rhinosys/turingpi2_rack/docs/index.md

# Turing Pi 2 · Rack Blade

**19-inch / 4U · Two removable nodes · SolidCraft CAD · Black PETG**

[English documentation](en/index.md) · [Documentation française](fr/index.md)

Integrated enclosure, V6 architecture retained in V7

A documented prototype, from the initial brief to calibrated printing files and physical fit corrections.
Un prototype documenté, du cahier des charges initial aux fichiers d’impression calibrés et aux corrections après essai.

**Current / Actuel:** rack **V7 calibrated / calibrée**, rail saddles / supports de rails **R3**.

[GitHub sources](https://github.com/rhinosys/turingpi2_rack) · [Downloads / Téléchargements](en/files.md)
