rhinosys/turingpi2_rack/CAD/RackBladeSolidCraft/LIRE_V5.md

# Ouvrir la version 5

Fichier complet : **[RackTuringPi2_Complet_V5.solidcraft](RackTuringPi2_Complet_V5.solidcraft)**.

Cette version remplace le tiroir court par deux cassettes complètes. Façade, plateau, carte, ventilateur, alimentation et paroi arrière sont regroupés dans **CASSETTE-G** et **CASSETTE-D**. Les câbles externes doivent être débranchés avant extraction. Le châssis fixe conserve structure, guides et enveloppe de ventilation.

Voir **[la notice V5](V5/README.md)** pour les vues, pièces imprimables, étapes de montage et limites du prototype. Les anciennes notices V1/V2 et l'animation du tiroir court expliquent le R3/R4 ; elles ne décrivent pas le nouveau fond mobile de V5.

Extraction complète V5

Rechargement natif vérifié : 53 corps, 743 opérations, aucune erreur. Chaque corps comporte une coque. Les essais discrets de mouvement sont consignés dans `V5/verification/`.
