rhinosys/turingpi2_rack/CAD/RackBladeSolidCraft/animation-guidage/sortie.png

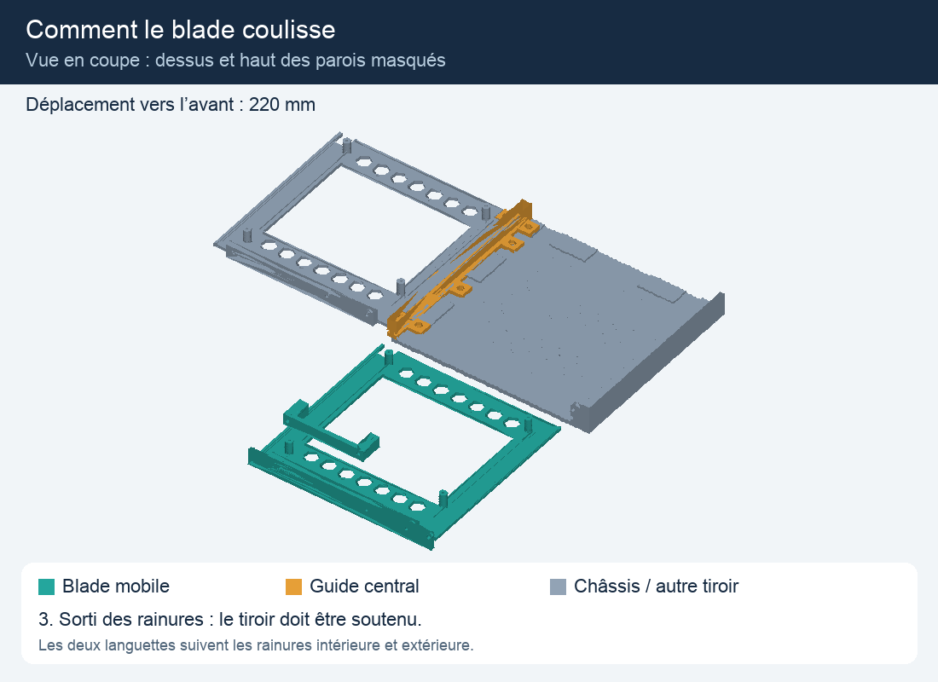
CAD/RackBladeSolidCraft/animation-guidage/sortie.png
