rhinosys/turingpi2_rack/CAD/RackBladeSolidCraft/notice-visuelle/blade.png

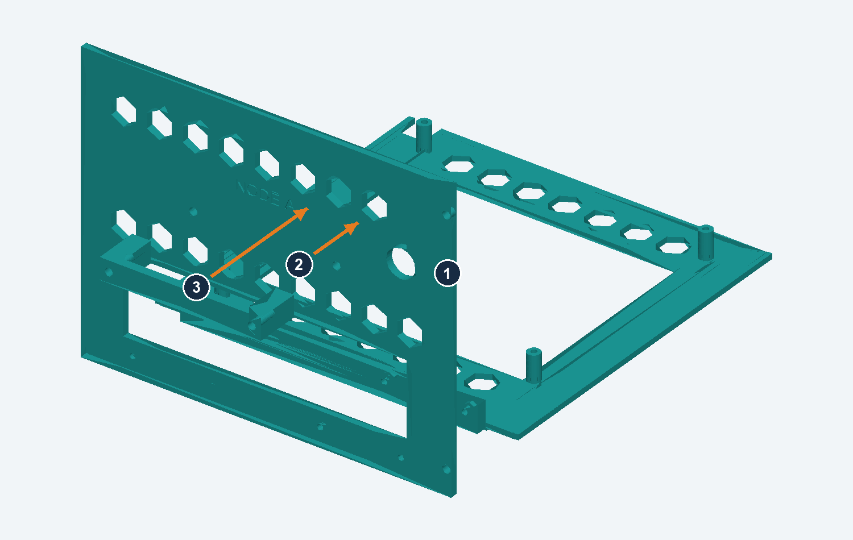
CAD/RackBladeSolidCraft/notice-visuelle/blade.png
