rhinosys/turingpi2_rack/CAD/RackBladeSolidCraft/notice-visuelle/capots.png

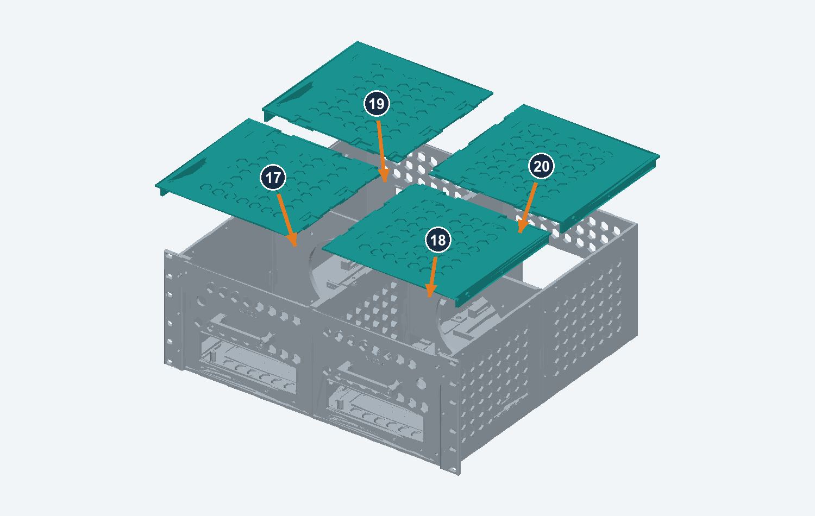
CAD/RackBladeSolidCraft/notice-visuelle/capots.png
