rhinosys/turingpi2_rack/CAD/RackBladeSolidCraft/notice-visuelle/cloisons.png

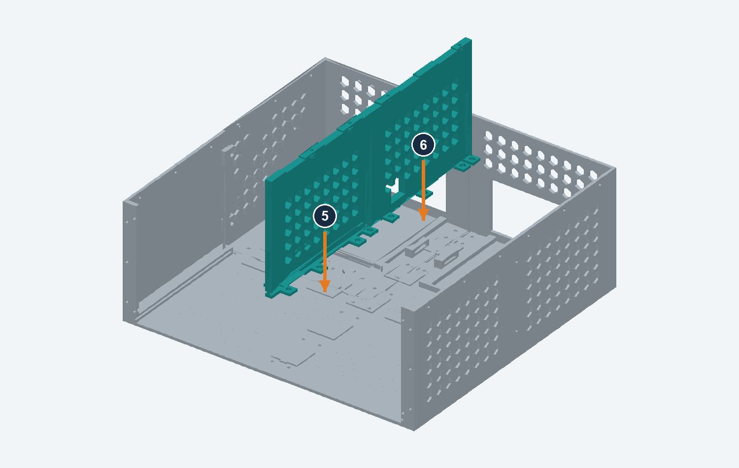
CAD/RackBladeSolidCraft/notice-visuelle/cloisons.png
