rhinosys/turingpi2_rack/CAD/RackBladeSolidCraft/notice-visuelle/final.png

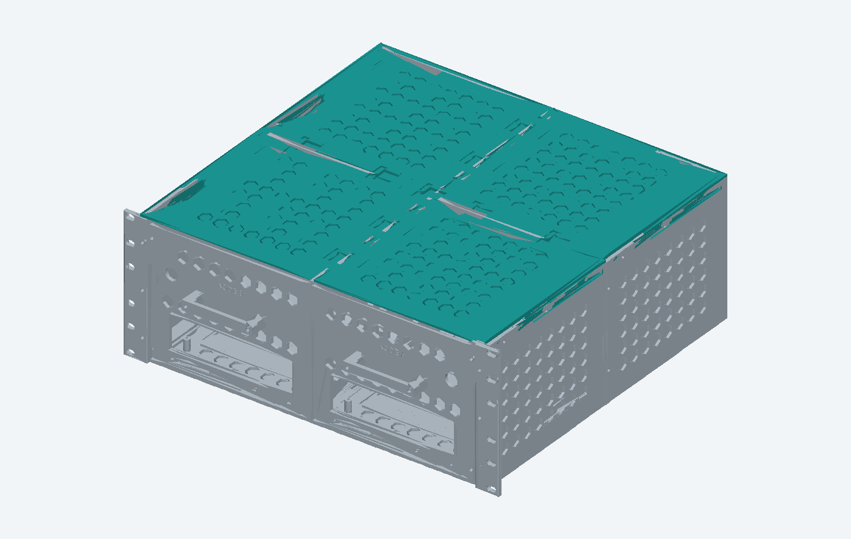
CAD/RackBladeSolidCraft/notice-visuelle/final.png
