rhinosys/turingpi2_rack/CAD/RackBladeSolidCraft/notice-visuelle/guidage.png

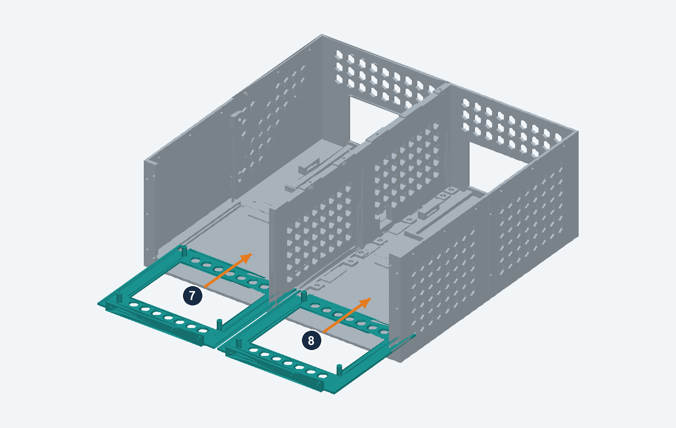
CAD/RackBladeSolidCraft/notice-visuelle/guidage.png
