rhinosys/turingpi2_rack/CAD/RackBladeSolidCraft/notice-visuelle/oreilles.png

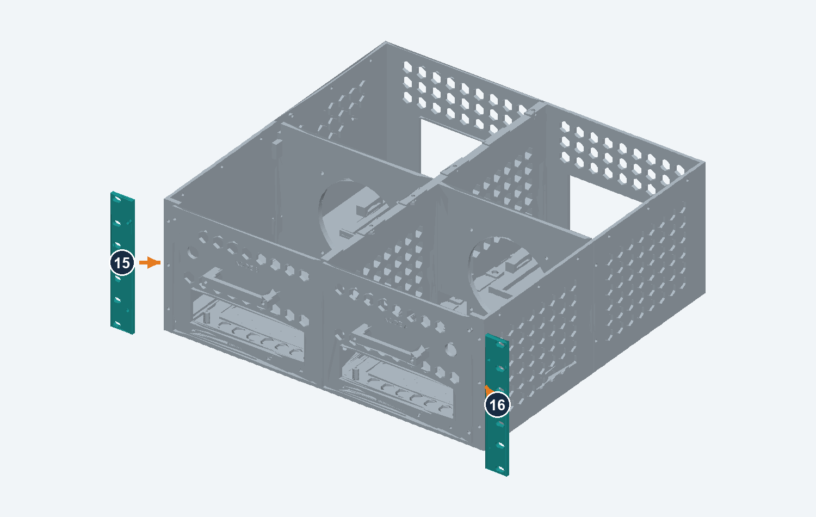
CAD/RackBladeSolidCraft/notice-visuelle/oreilles.png
