rhinosys/turingpi2_rack/CAD/RackBladeSolidCraft/notice-visuelle/quadrants.png

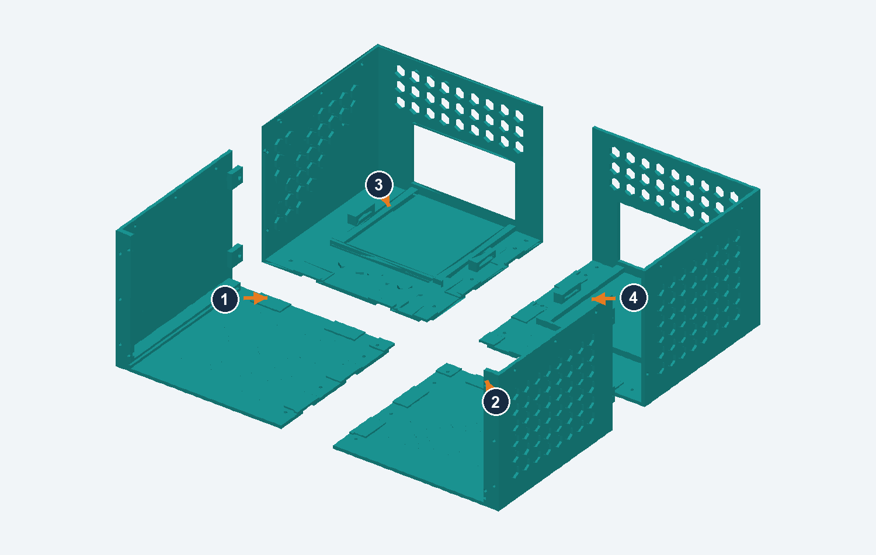
CAD/RackBladeSolidCraft/notice-visuelle/quadrants.png
