rhinosys/turingpi2_rack/CAD/RackBladeSolidCraft/notice-visuelle/ventilos.png

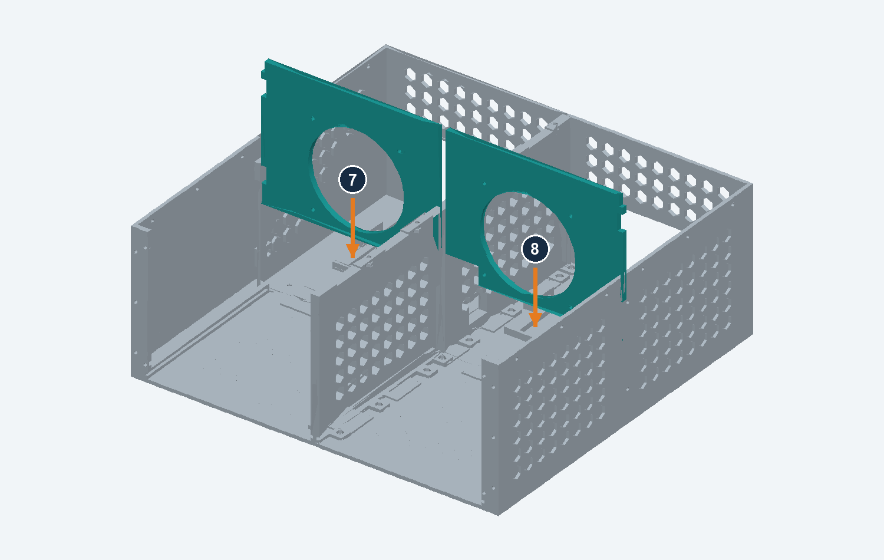
CAD/RackBladeSolidCraft/notice-visuelle/ventilos.png
