rhinosys/turingpi2_rack/CAD/RackBladeSolidCraft/previews/part-BIS-X.png

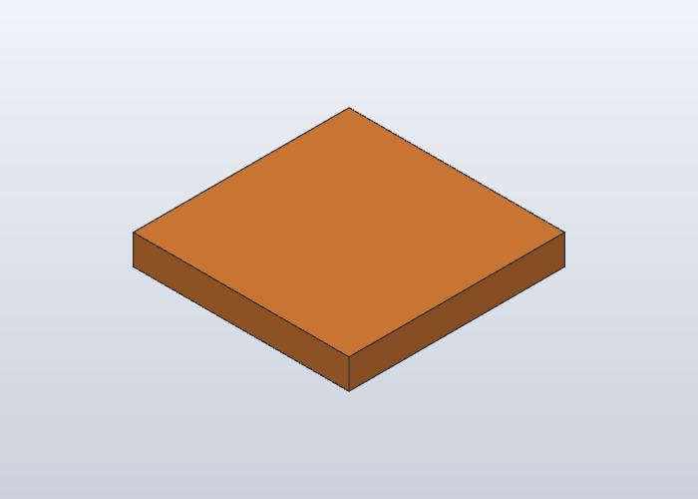
CAD/RackBladeSolidCraft/previews/part-BIS-X.png
