rhinosys/turingpi2_rack/CAD/RackBladeSolidCraft/previews/part-BT-D.png

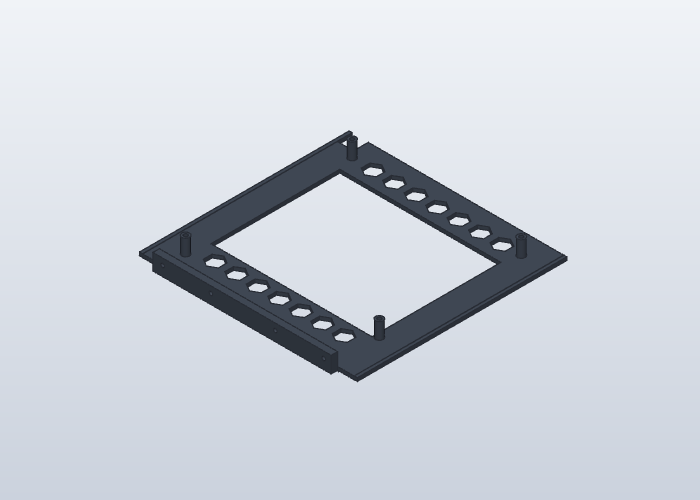
CAD/RackBladeSolidCraft/previews/part-BT-D.png
