rhinosys/turingpi2_rack/CAD/RackBladeSolidCraft/previews/part-EAR-D.png

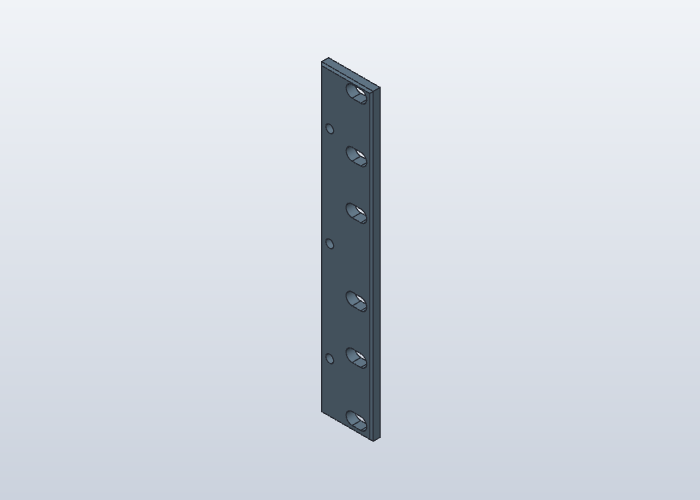
CAD/RackBladeSolidCraft/previews/part-EAR-D.png
