rhinosys/turingpi2_rack/CAD/RackBladeSolidCraft/previews/part-FW-D.png

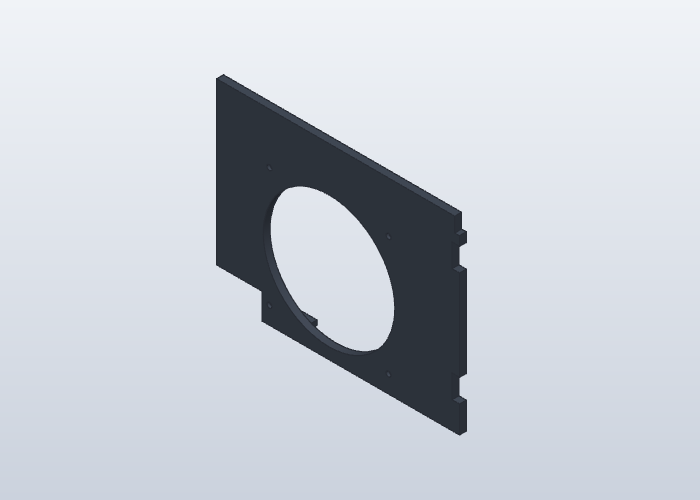
CAD/RackBladeSolidCraft/previews/part-FW-D.png
