rhinosys/turingpi2_rack/CAD/RackBladeSolidCraft/previews/part-HANDLE-D.png

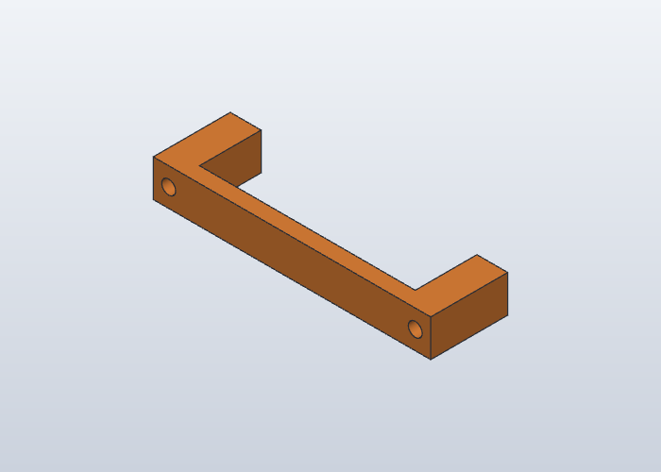
CAD/RackBladeSolidCraft/previews/part-HANDLE-D.png
