rhinosys/turingpi2_rack/CAD/RackBladeSolidCraft/previews/part-Q-AR-D.png

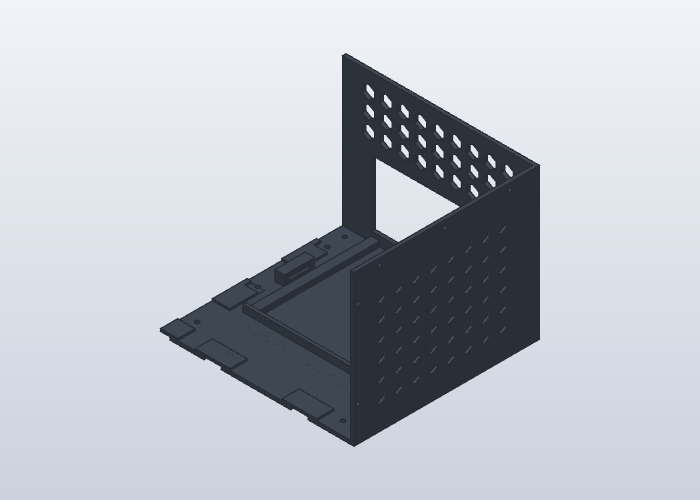
CAD/RackBladeSolidCraft/previews/part-Q-AR-D.png
