rhinosys/turingpi2_rack/CAD/RackBladeSolidCraft/previews/part-Q-AR-G.png

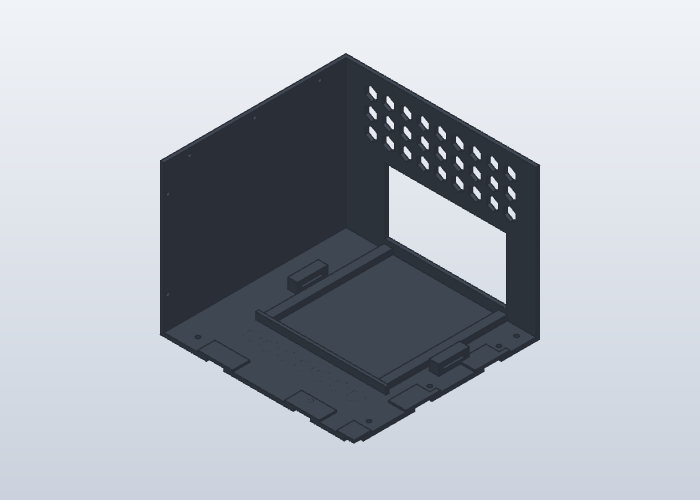
CAD/RackBladeSolidCraft/previews/part-Q-AR-G.png
