rhinosys/turingpi2_rack/CAD/RackBladeSolidCraft/previews/part-Q-AV-D.png

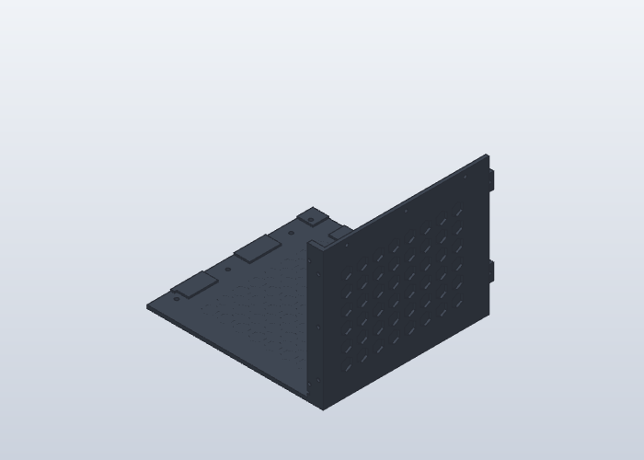
CAD/RackBladeSolidCraft/previews/part-Q-AV-D.png
