rhinosys/turingpi2_rack/CAD/RackBladeSolidCraft/previews/part-TOP-AR-D.png

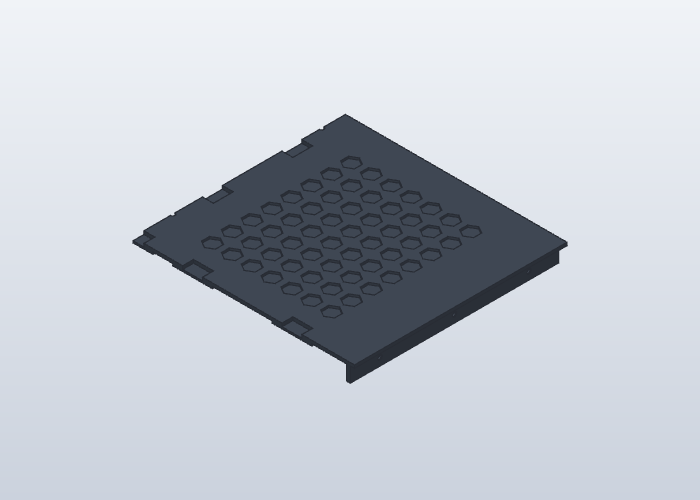
CAD/RackBladeSolidCraft/previews/part-TOP-AR-D.png
