rhinosys/turingpi2_rack/CAD/RackBladeSolidCraft/V7/plateaux/01_Q-AV-D.png

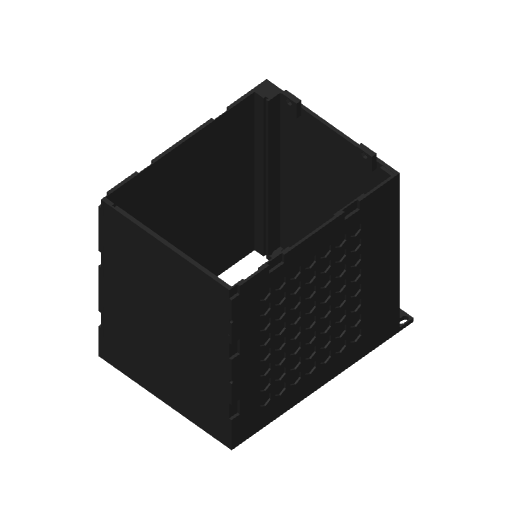
CAD/RackBladeSolidCraft/V7/plateaux/01_Q-AV-D.png
