rhinosys/turingpi2_rack/CAD/RackBladeSolidCraft/V7/plateaux/03_Q-AR-D.png

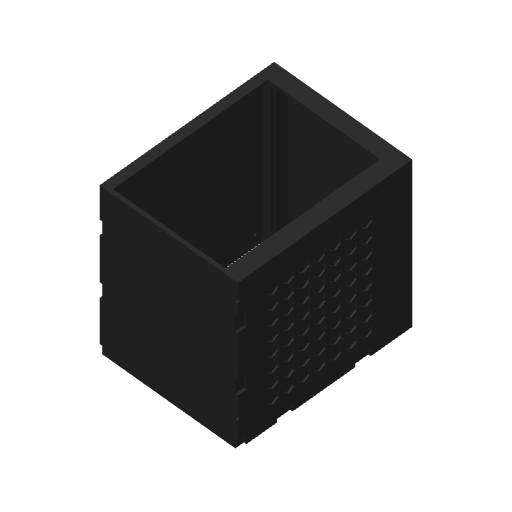
CAD/RackBladeSolidCraft/V7/plateaux/03_Q-AR-D.png
