rhinosys/turingpi2_rack/CAD/RackBladeSolidCraft/V7/plateaux/05_BT-D.png

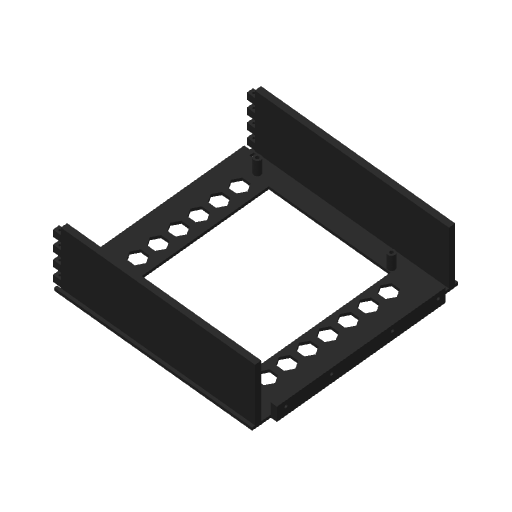
CAD/RackBladeSolidCraft/V7/plateaux/05_BT-D.png
