rhinosys/turingpi2_rack/CAD/RackBladeSolidCraft/V7/plateaux/06_FOND-AR-D.png

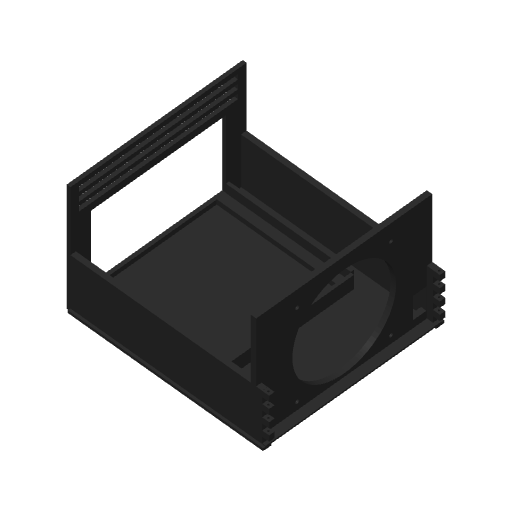
CAD/RackBladeSolidCraft/V7/plateaux/06_FOND-AR-D.png
