rhinosys/turingpi2_rack/CAD/RackBladeSolidCraft/V7/plateaux/09_Facade_D_poignee_biscuits.png

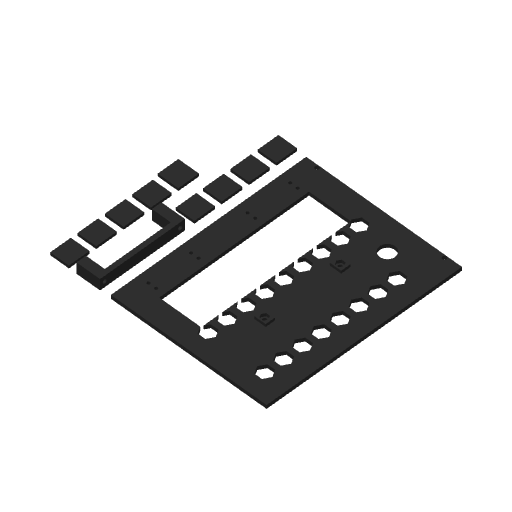
CAD/RackBladeSolidCraft/V7/plateaux/09_Facade_D_poignee_biscuits.png
