rhinosys/turingpi2_rack/CAD/RackBladeSolidCraft/V7/exports/Assemblage_V7.step

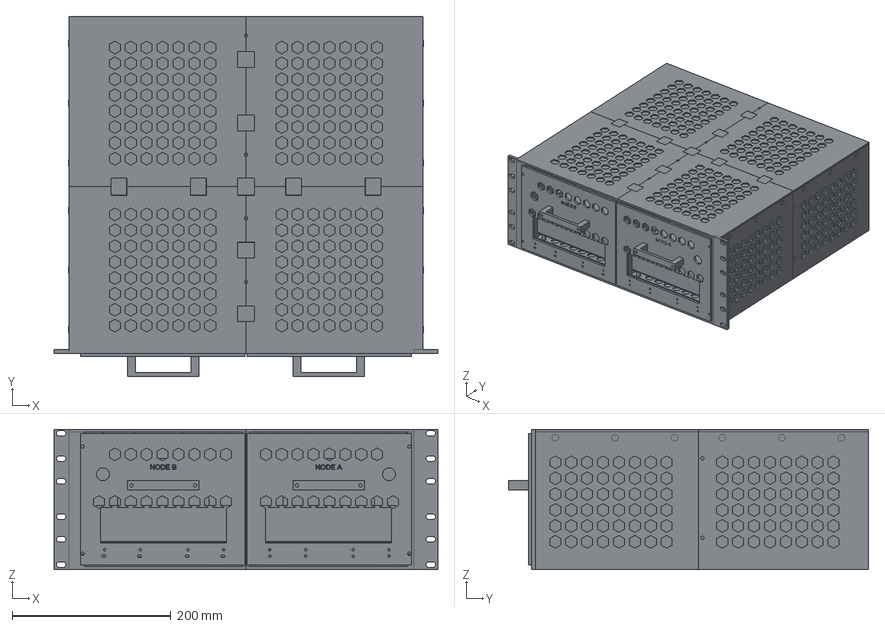
[picture p45: CAD file, 2026-10-26]
CAD/RackBladeSolidCraft/V7/exports/Assemblage_V7.step
482.6 x 453.0 x 176.5 mm
