rhinosys/turingpi2_rack/CAD/RackBladeSolidCraft/exports/3mf/BIS_20_plus_BIS-X_2.3mf

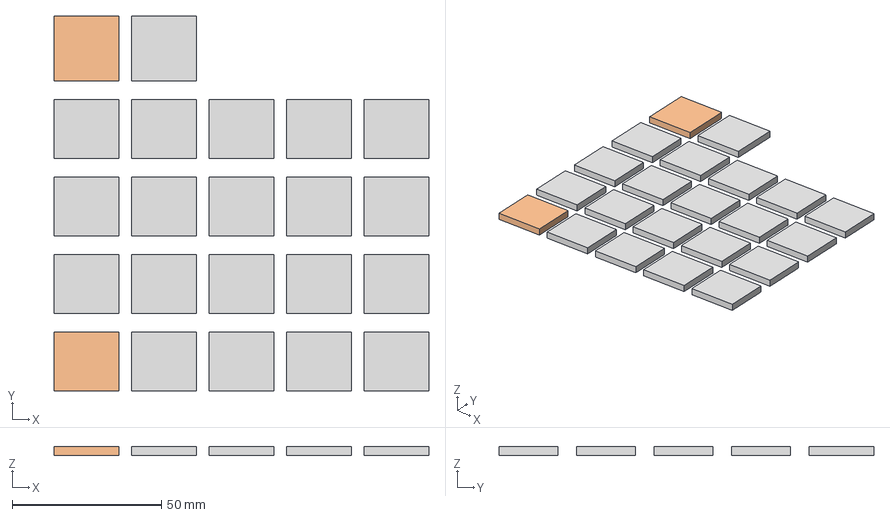
[picture p46: CAD file, 2026-10-26]
CAD/RackBladeSolidCraft/exports/3mf/BIS_20_plus_BIS-X_2.3mf
125.8 x 125.8 x 3.00 mm
BIS
BIS (2)
BIS (3)
BIS (4)
BIS (5)
BIS (6)
BIS (7)
BIS (8)
BIS (9)
BIS (10)
BIS (11)
BIS (12)
BIS (13)
BIS (14)
BIS (15)
BIS (16)
BIS (17)
BIS (18)
BIS (19)
BIS (20)
BIS-X (2)
BIS-X
