rhinosys/turingpi2_rack/CAD/RackBladeSolidCraft/exports/step/Q-AR-G.step

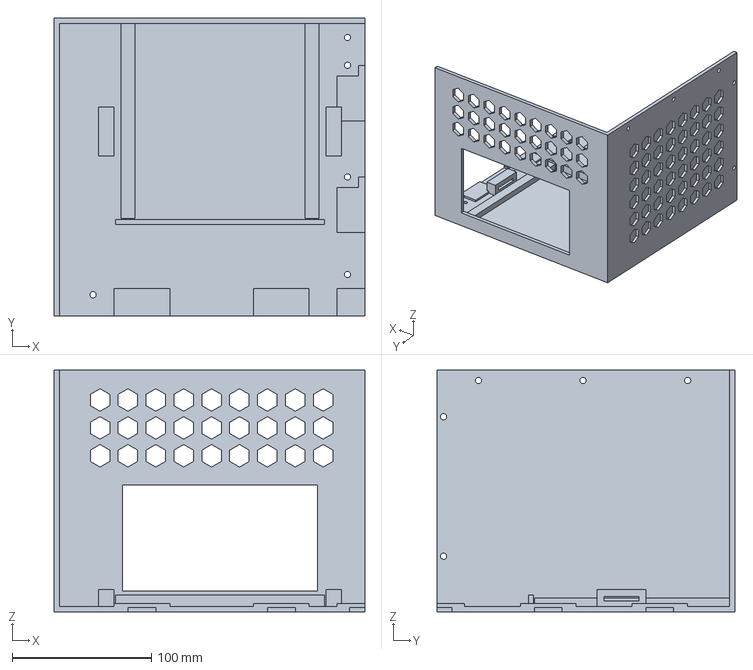
[picture p47: CAD file, 2026-10-26]
CAD/RackBladeSolidCraft/exports/step/Q-AR-G.step
223.0 x 213.8 x 173.5 mm
