rhinosys/turingpi2_rack/CAD/RackBladeSolidCraft/Supports_Rails_L/exports/BERCEAU-A.step

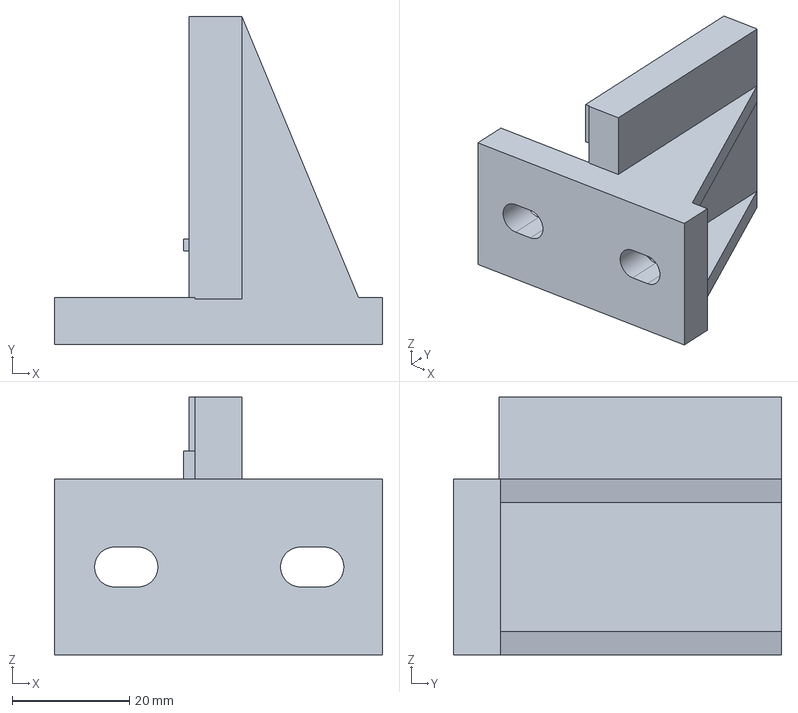
[picture p48: CAD file, 2026-10-26]
CAD/RackBladeSolidCraft/Supports_Rails_L/exports/BERCEAU-A.step
56.0 x 56.0 x 44.0 mm
