rhinosys/turingpi2_rack/CAD/RackBladeSolidCraft/Supports_Rails_L/Plateau_4_berceaux_PETG_noir.3mf

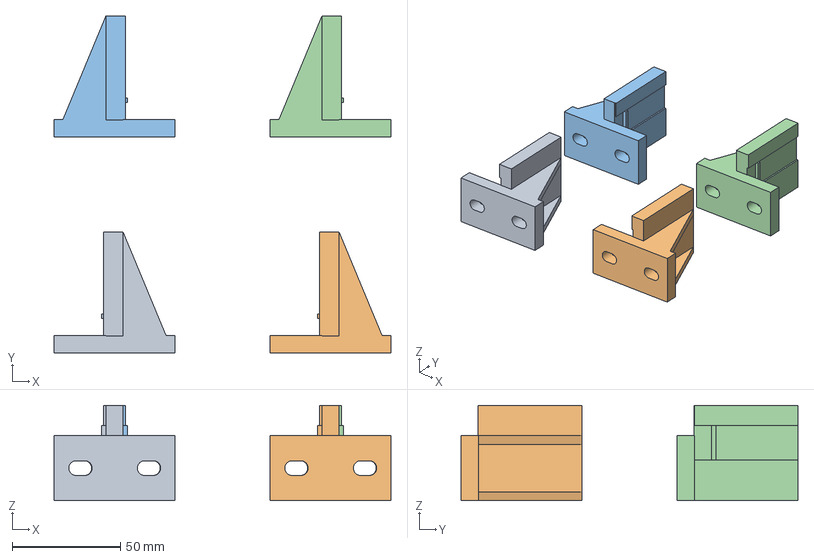
[picture p49: CAD file, 2026-10-26]
CAD/RackBladeSolidCraft/Supports_Rails_L/Plateau_4_berceaux_PETG_noir.3mf
156.0 x 156.0 x 44.0 mm
BERCEAU-A-1
BERCEAU-A-2
BERCEAU-B-3
BERCEAU-B-4
