rhinosys/turingpi2_rack/CAD/RackBladeSolidCraft/Supports_Rails_L/R2/Plateau_2_arriere_M4_R2_PETG_noir.3mf

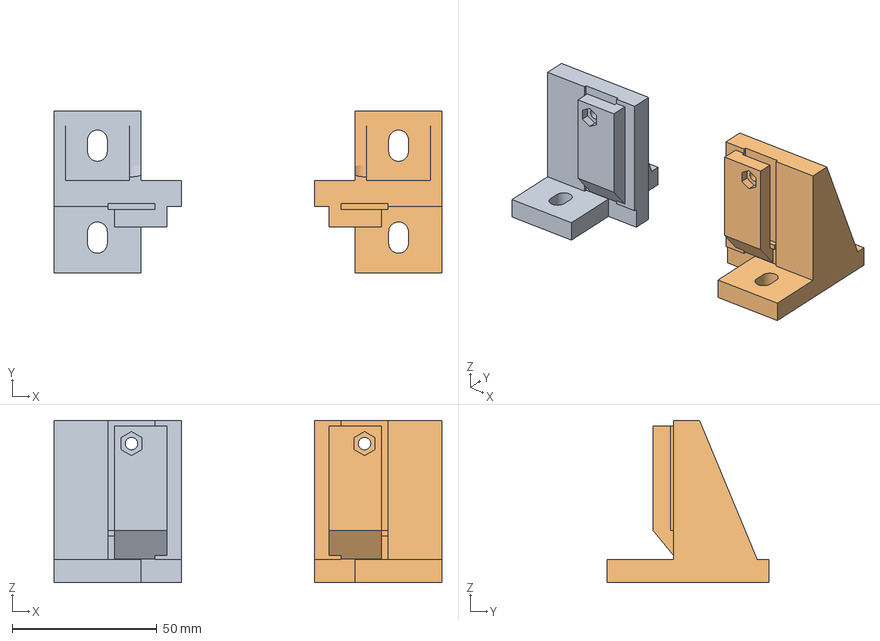
[picture p51: CAD file, 2026-10-26]
CAD/RackBladeSolidCraft/Supports_Rails_L/R2/Plateau_2_arriere_M4_R2_PETG_noir.3mf
134.0 x 56.0 x 56.0 mm
AR-A-1
AR-B-2
