rhinosys/turingpi2_rack/CAD/RackBladeSolidCraft/Supports_Rails_L/R3/exports/AR-A.step

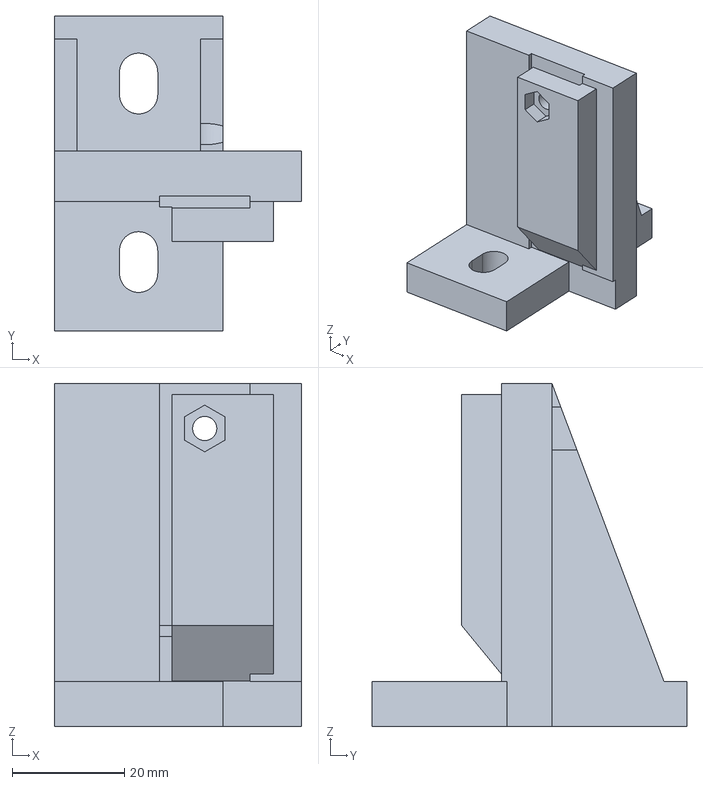
[picture p52: CAD file, 2026-10-26]
CAD/RackBladeSolidCraft/Supports_Rails_L/R3/exports/AR-A.step
44.0 x 56.0 x 61.0 mm
