rhinosys/turingpi2_rack/CAD/RackBladeSolidCraft/Supports_Rails_L/R3/Plateau_2_arriere_M4_R3_PETG_noir.3mf

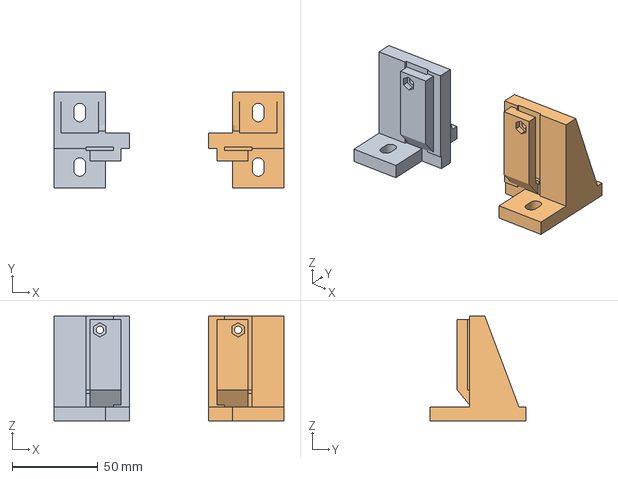
[picture p53: CAD file, 2026-10-26]
CAD/RackBladeSolidCraft/Supports_Rails_L/R3/Plateau_2_arriere_M4_R3_PETG_noir.3mf
134.0 x 56.0 x 61.0 mm
AR-A-1
AR-B-2
