rhinosys/turingpi2_rack/CAD/RackBladeSolidCraft/Tolerances/Rack_Tolerance_PETG_R1.step

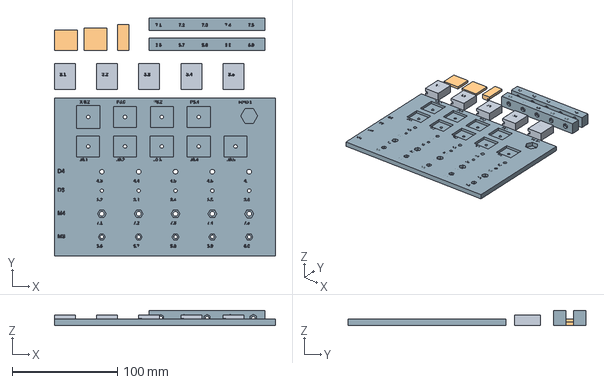
[picture p54: CAD file, 2026-10-26]
CAD/RackBladeSolidCraft/Tolerances/Rack_Tolerance_PETG_R1.step
210.0 x 226.0 x 14.0 mm
