rhinosys/turingpi2_rack/CAD/RackBladeSolidCraft/V7/exports/Q-AR-D_print.step

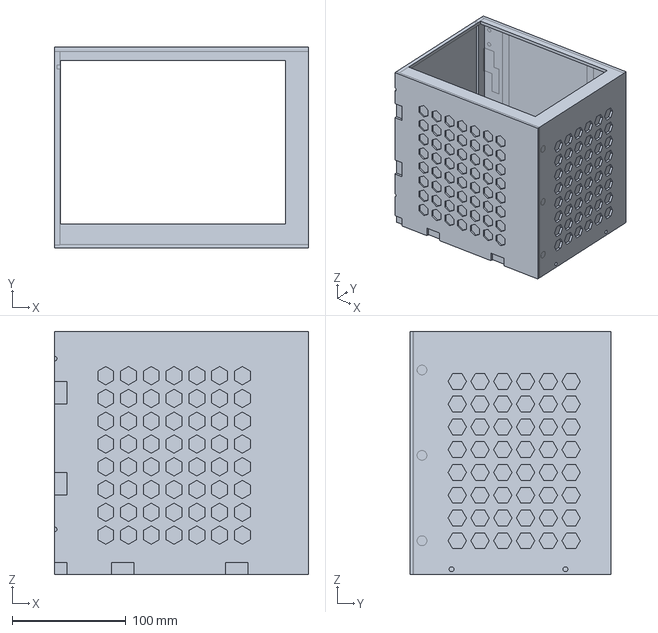
[picture p55: CAD file, 2026-10-26]
CAD/RackBladeSolidCraft/V7/exports/Q-AR-D_print.step
223.1 x 176.5 x 213.8 mm
