rhinosys/turingpi2_rack/CAD/RackBladeSolidCraft/V7/plateaux/01_Q-AV-D.3mf

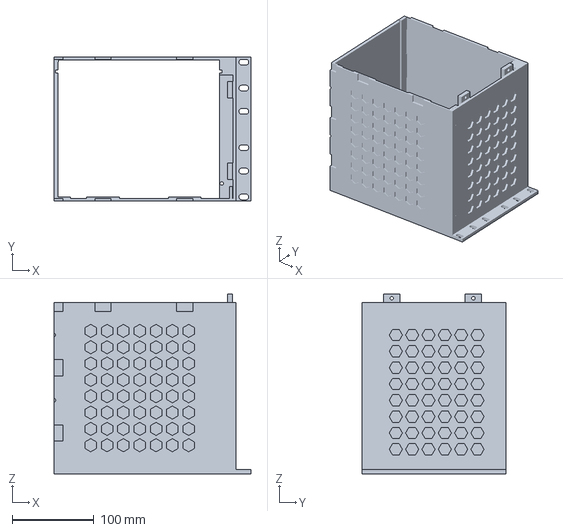
[picture p56: CAD file, 2026-10-26]
CAD/RackBladeSolidCraft/V7/plateaux/01_Q-AV-D.3mf
241.3 x 176.5 x 220.0 mm
