rhinosys/turingpi2_rack/CAD/RackBladeSolidCraft/Variants/Q-AV-G-EAR/Q-AV-G-EAR_face-avant.3mf

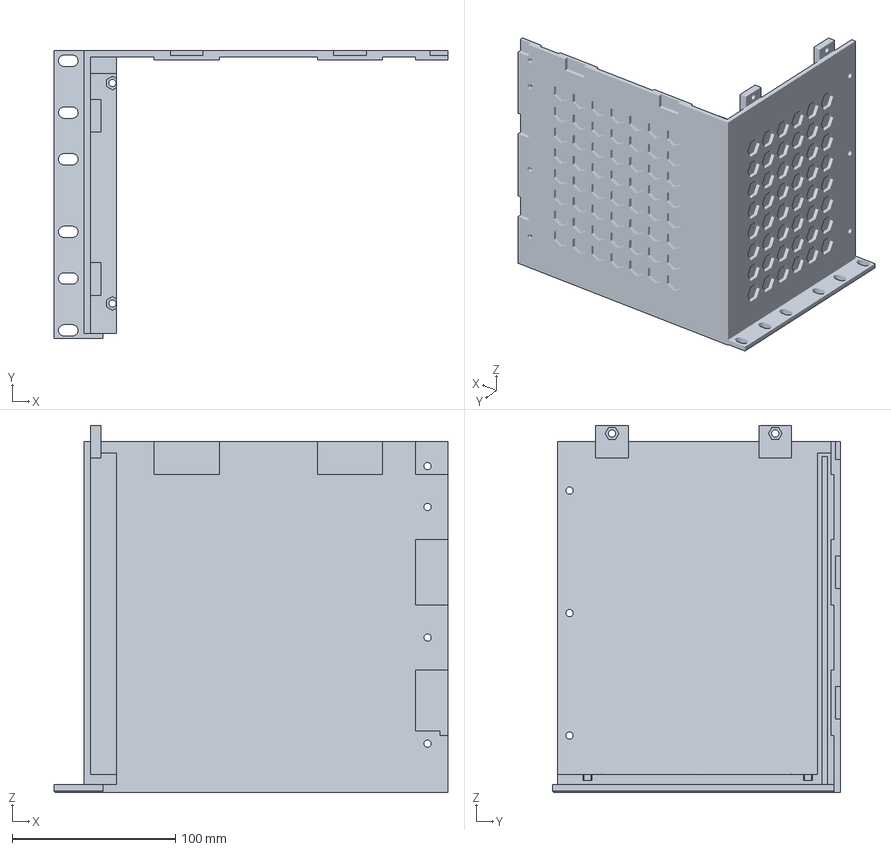
[picture p57: CAD file, 2026-10-26]
CAD/RackBladeSolidCraft/Variants/Q-AV-G-EAR/Q-AV-G-EAR_face-avant.3mf
241.3 x 176.5 x 225.0 mm
