rhinosys/turingpi2_rack/CAD/RackBladeSolidCraft/exports/step/BF-G.step

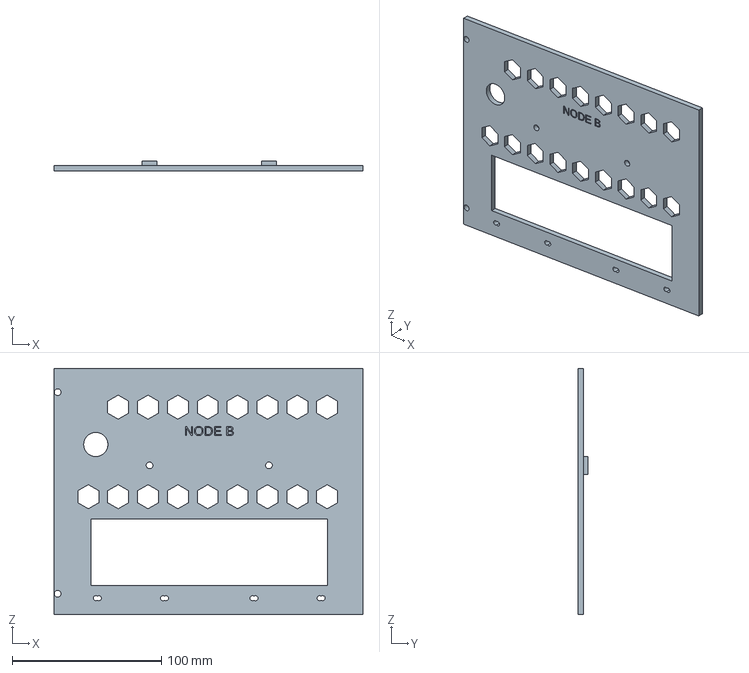
[picture p58: CAD file, 2026-10-26]
CAD/RackBladeSolidCraft/exports/step/BF-G.step
207.0 x 7.00 x 165.0 mm
