rhinosys/turingpi2_rack/CAD/RackBladeSolidCraft/Supports_Rails_L/exports/Montage_berceaux_reference.step

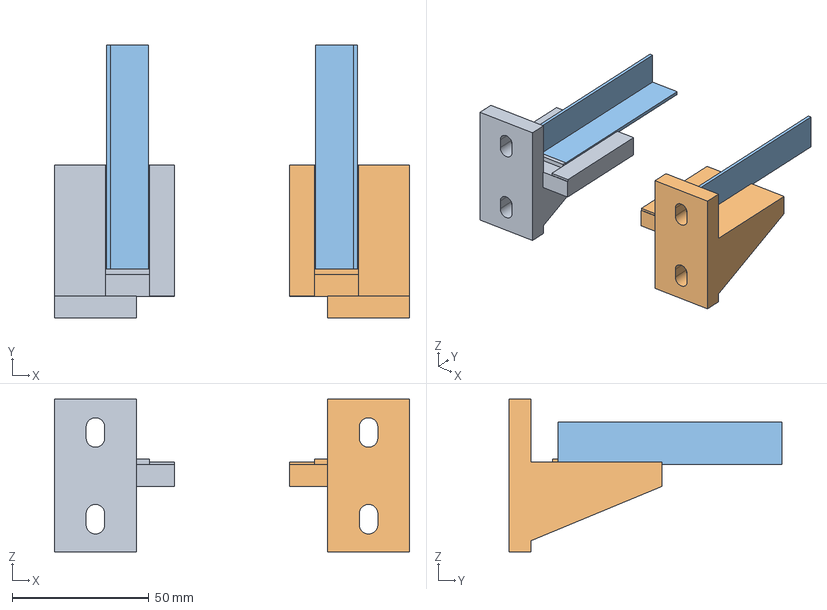
[picture p59: CAD file, 2026-10-26]
CAD/RackBladeSolidCraft/Supports_Rails_L/exports/Montage_berceaux_reference.step
130.0 x 100.0 x 56.0 mm
