rhinosys/turingpi2_rack/CAD/RackBladeSolidCraft/Supports_Rails_L/R2/exports/AR-A.step

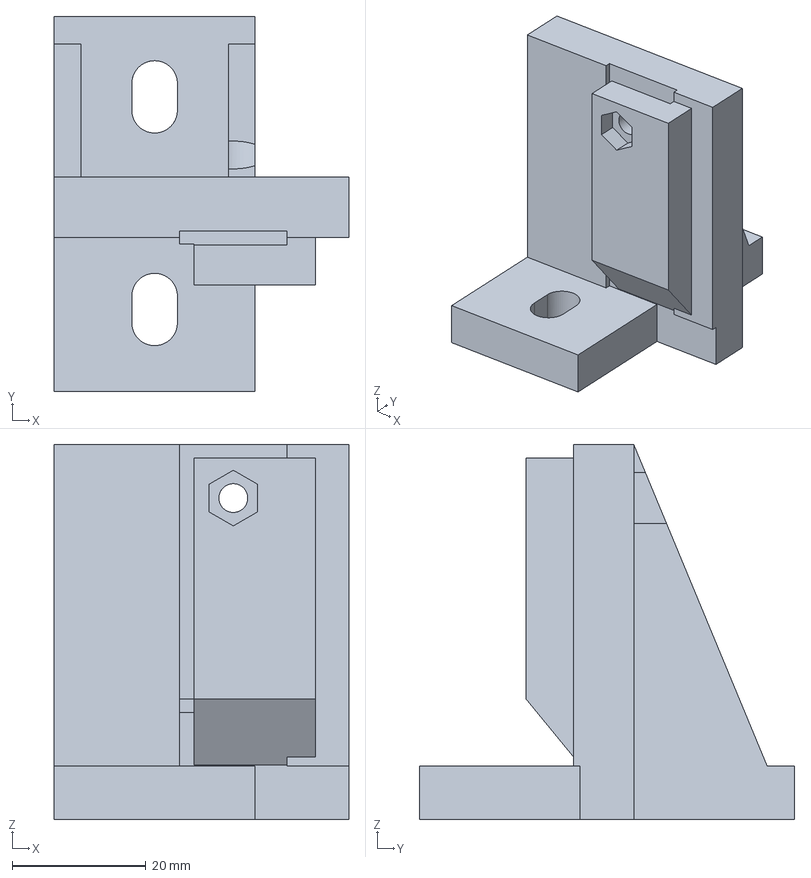
[picture p60: CAD file, 2026-10-26]
CAD/RackBladeSolidCraft/Supports_Rails_L/R2/exports/AR-A.step
44.0 x 56.0 x 56.0 mm
