rhinosys/turingpi2_rack/CAD/RackBladeSolidCraft/Supports_Rails_L/R2/Plateau_4_supports_R2_PETG_noir.3mf

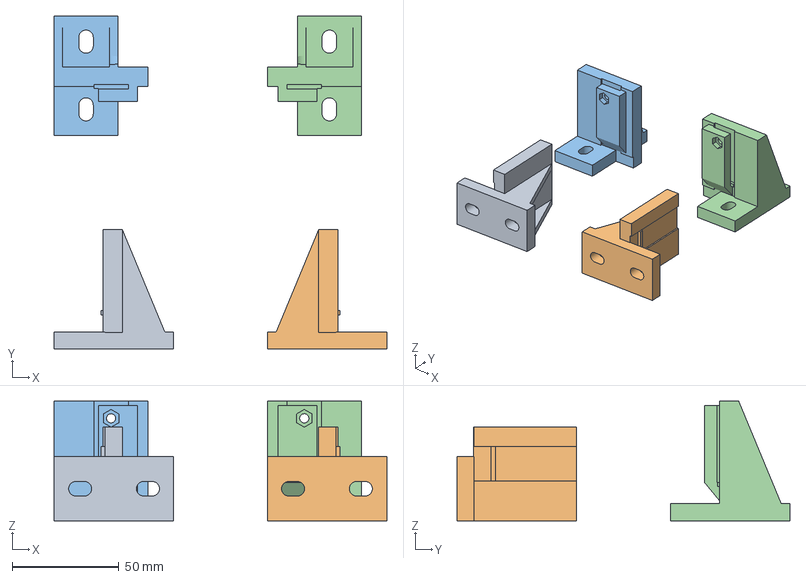
[picture p61: CAD file, 2026-10-26]
CAD/RackBladeSolidCraft/Supports_Rails_L/R2/Plateau_4_supports_R2_PETG_noir.3mf
156.0 x 156.0 x 56.0 mm
AV-A-1
AV-B-2
AR-A-3
AR-B-4
