rhinosys/turingpi2_rack/CAD/RackBladeSolidCraft/Supports_Rails_L/R3/Plateau_4_supports_R3_PETG_noir.3mf

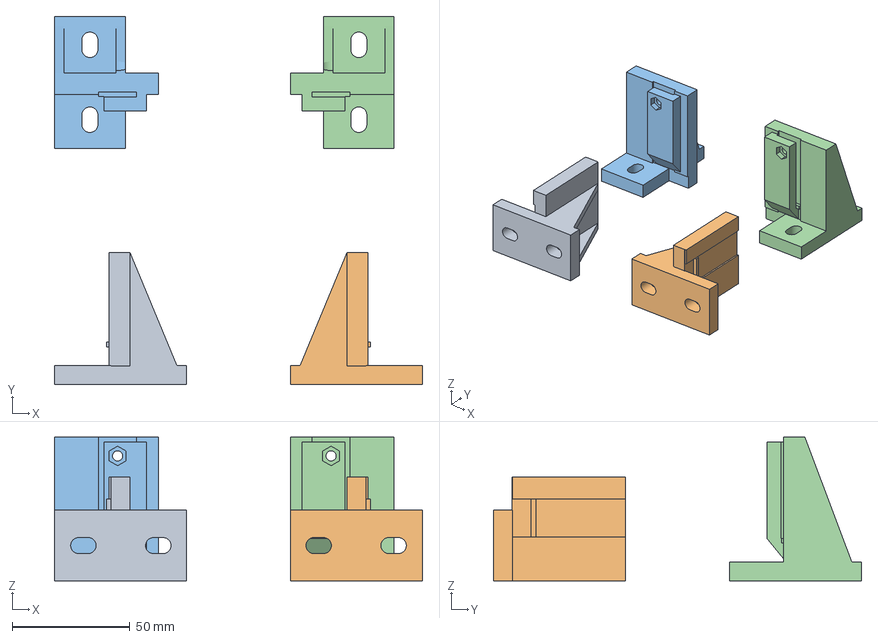
[picture p63: CAD file, 2026-10-26]
CAD/RackBladeSolidCraft/Supports_Rails_L/R3/Plateau_4_supports_R3_PETG_noir.3mf
156.0 x 156.0 x 61.0 mm
AV-A-1
AV-B-2
AR-A-3
AR-B-4
