rhinosys/turingpi2_rack/CAD/RackBladeSolidCraft/V7/exports/BT-D_print.step

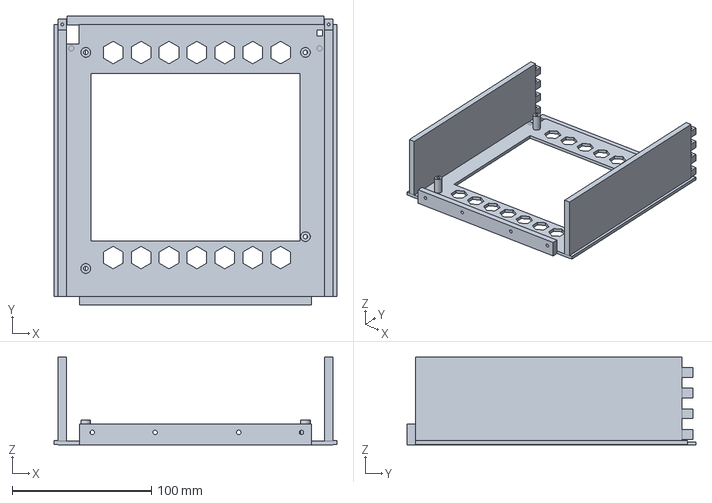
[picture p64: CAD file, 2026-10-26]
CAD/RackBladeSolidCraft/V7/exports/BT-D_print.step
202.8 x 207.2 x 63.0 mm
