rhinosys/turingpi2_rack/CAD/RackBladeSolidCraft/exports/step/HANDLE-G.step

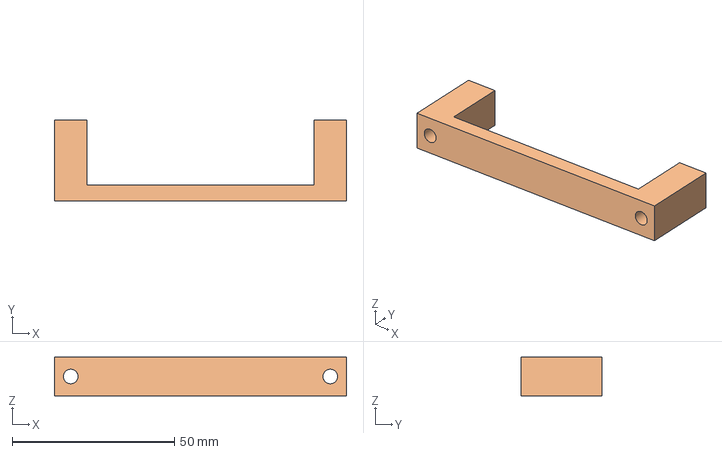
[picture p65: CAD file, 2026-10-26]
CAD/RackBladeSolidCraft/exports/step/HANDLE-G.step
90.0 x 25.0 x 12.0 mm
