rhinosys/turingpi2_rack/CAD/RackBladeSolidCraft/Supports_Rails_L/exports/Supports_Rails_L.step

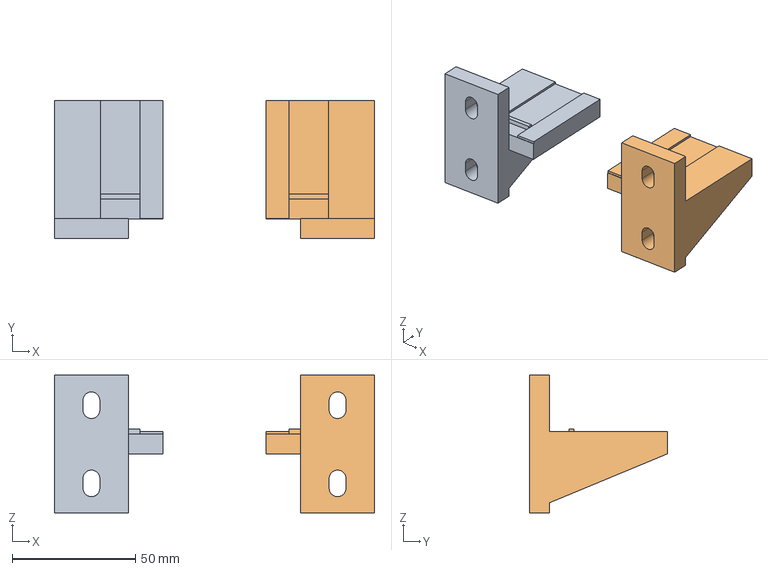
[picture p66: CAD file, 2026-10-26]
CAD/RackBladeSolidCraft/Supports_Rails_L/exports/Supports_Rails_L.step
130.0 x 56.0 x 56.0 mm
