rhinosys/turingpi2_rack/CAD/RackBladeSolidCraft/V7/plateaux/08_FOND-AR-G.3mf

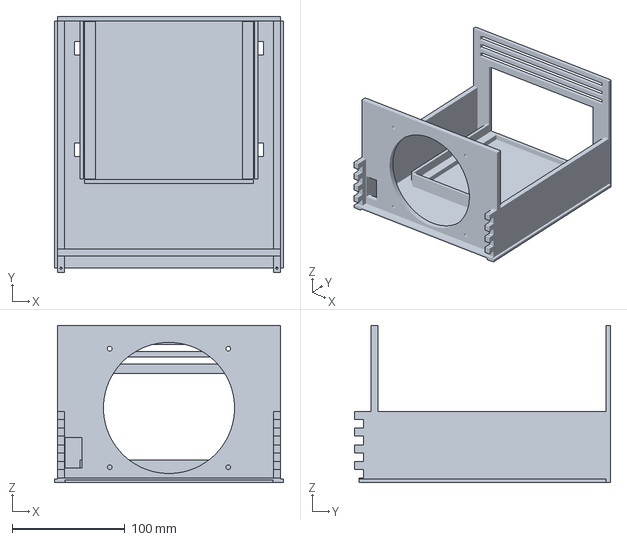
[picture p68: CAD file, 2026-10-26]
CAD/RackBladeSolidCraft/V7/plateaux/08_FOND-AR-G.3mf
202.8 x 226.6 x 139.0 mm
