rhinosys/turingpi2_rack/CAD/RackBladeSolidCraft/exports/step/EAR-D.step

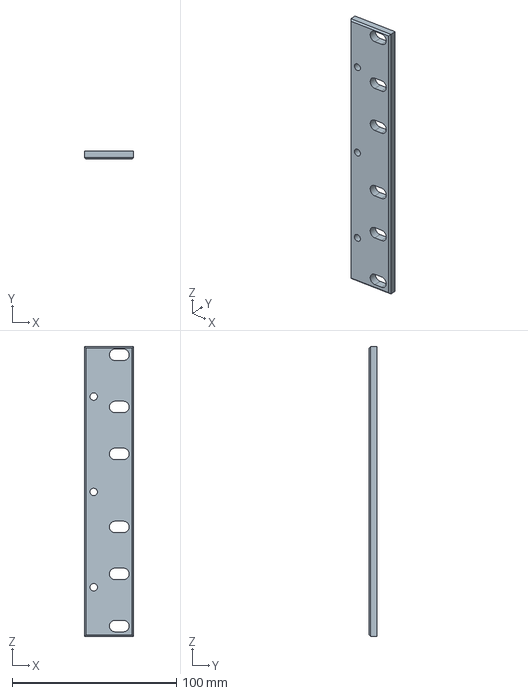
[picture p69: CAD file, 2026-10-26]
CAD/RackBladeSolidCraft/exports/step/EAR-D.step
30.0 x 5.00 x 176.5 mm
