rhinosys/turingpi2_rack/CAD/RackBladeSolidCraft/Supports_Rails_L/R2/exports/Supports_Rails_L.step

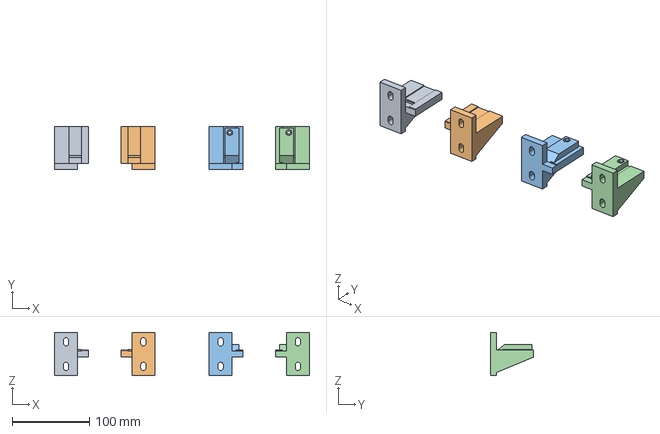
[picture p70: CAD file, 2026-10-26]
CAD/RackBladeSolidCraft/Supports_Rails_L/R2/exports/Supports_Rails_L.step
330.0 x 56.0 x 56.0 mm
