rhinosys/turingpi2_rack/CAD/RackBladeSolidCraft/V7/plateaux/09_Facade_D_poignee_biscuits.3mf

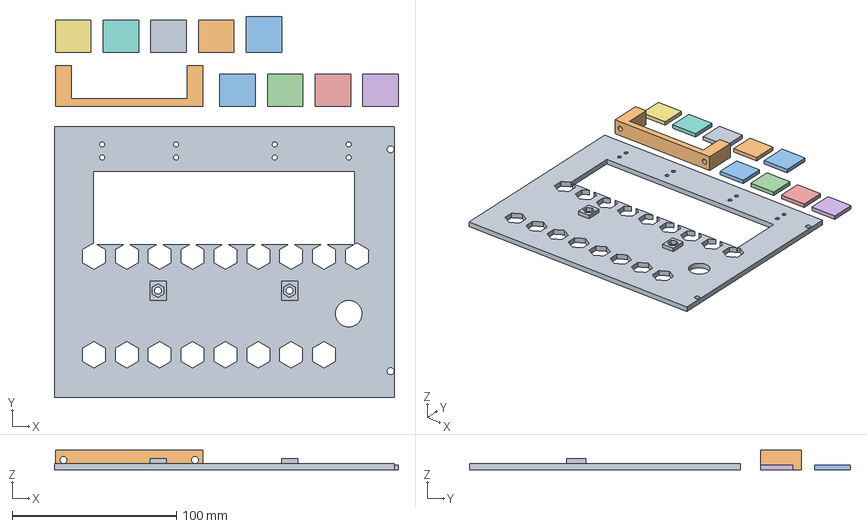
[picture p71: CAD file, 2026-10-26]
CAD/RackBladeSolidCraft/V7/plateaux/09_Facade_D_poignee_biscuits.3mf
209.3 x 231.8 x 12.0 mm
BF-D
HANDLE-D
BIS x 8
BIS-X
