rhinosys/turingpi2_rack/CAD/RackBladeSolidCraft/exports/step/TOP-AR-G.step

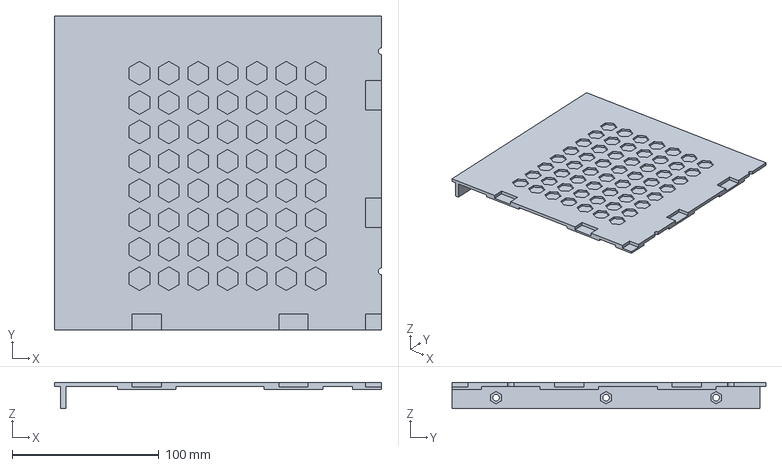
[picture p72: CAD file, 2026-10-26]
CAD/RackBladeSolidCraft/exports/step/TOP-AR-G.step
223.0 x 214.0 x 18.0 mm
