rhinosys/turingpi2_rack/CAD/RackBladeSolidCraft/exports/step/FW-D.step

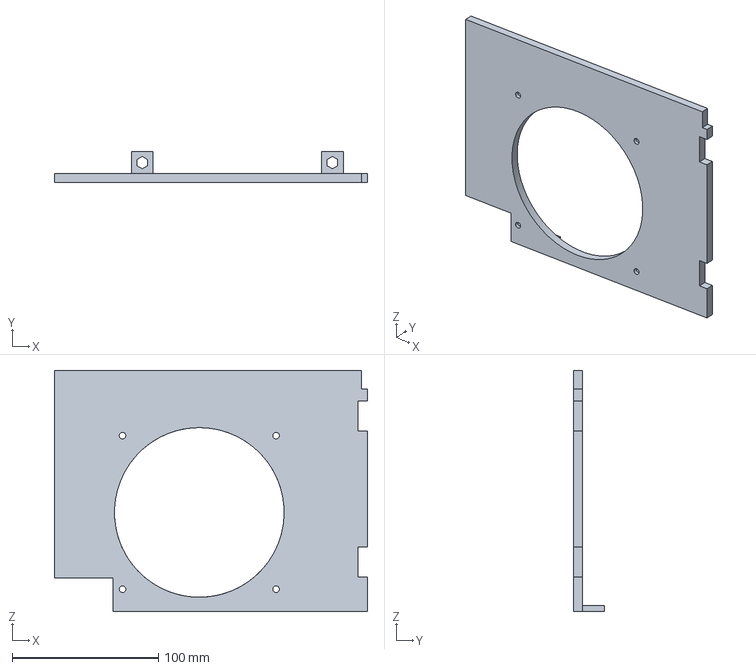
[picture p73: CAD file, 2026-10-26]
CAD/RackBladeSolidCraft/exports/step/FW-D.step
214.0 x 21.0 x 164.9 mm
