rhinosys/turingpi2_rack/CAD/RackBladeSolidCraft/V7/plateaux/11_OPTION_Test_filament_et_jonction.3mf

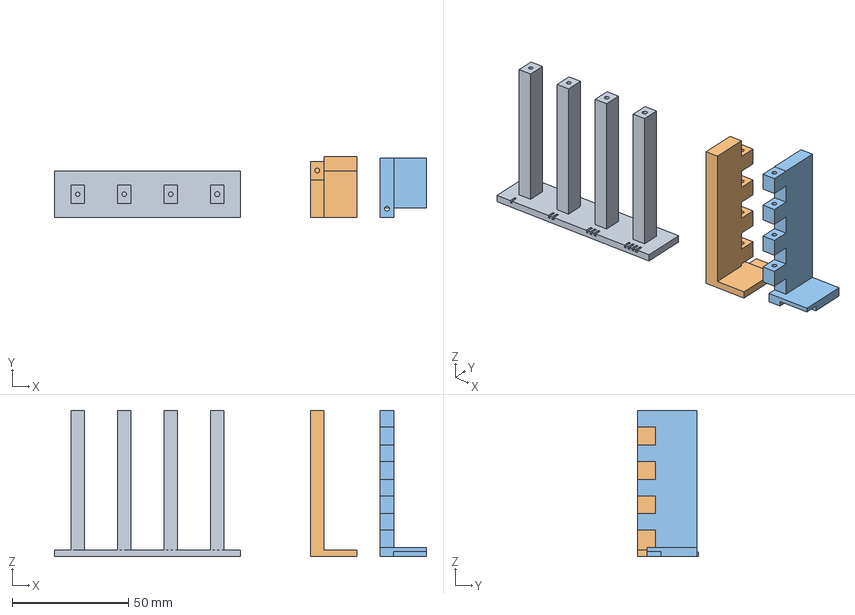
[picture p74: CAD file, 2026-10-26]
CAD/RackBladeSolidCraft/V7/plateaux/11_OPTION_Test_filament_et_jonction.3mf
160.0 x 26.2 x 63.0 mm
TEST-FILAMENT
TEST-JONCTION-1
TEST-JONCTION-2
