rhinosys/turingpi2_rack/CAD/RackBladeSolidCraft/exports/step/BT-D.step

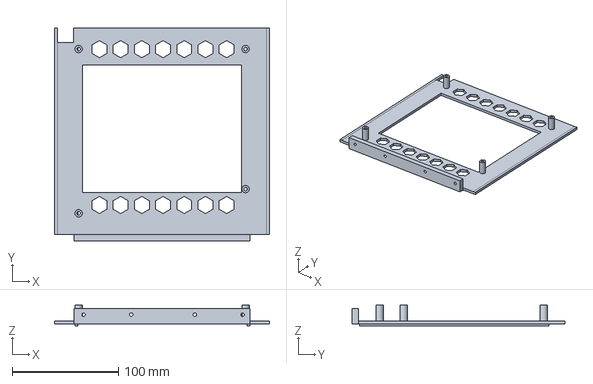
[picture p75: CAD file, 2026-10-26]
CAD/RackBladeSolidCraft/exports/step/BT-D.step
202.8 x 201.0 x 19.6 mm
