rhinosys/turingpi2_rack/CAD/RackBladeSolidCraft/exports/step/Q-AV-G.step

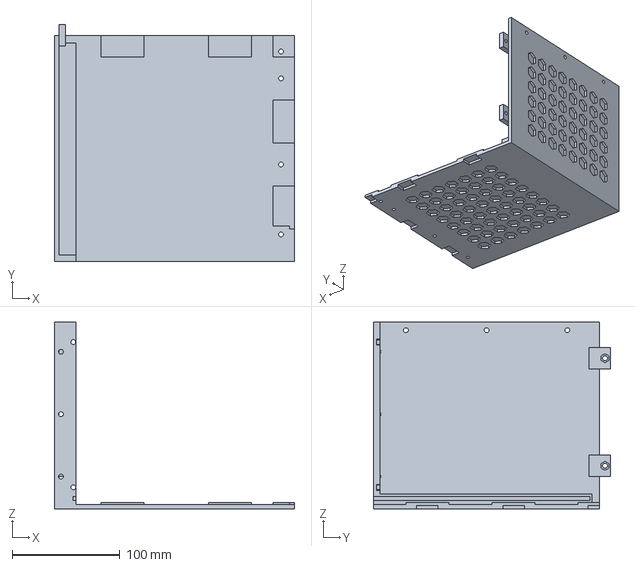
[picture p76: CAD file, 2026-10-26]
CAD/RackBladeSolidCraft/exports/step/Q-AV-G.step
223.0 x 220.0 x 173.5 mm
