rhinosys/turingpi2_rack/CAD/RackBladeSolidCraft/V7/exports/TEST-JONCTION.step

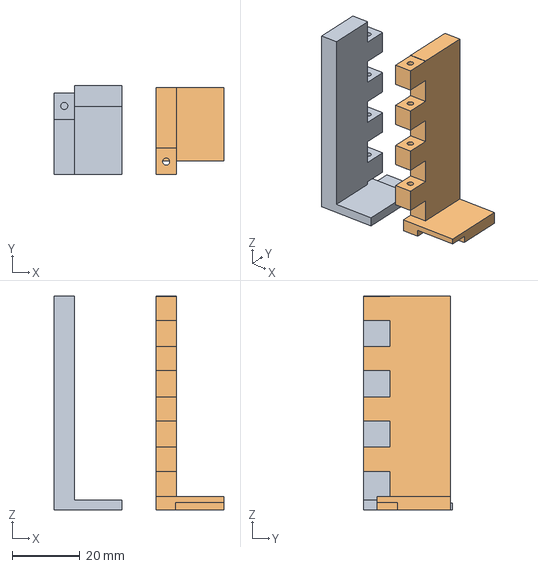
[picture p77: CAD file, 2026-10-26]
CAD/RackBladeSolidCraft/V7/exports/TEST-JONCTION.step
50.0 x 26.2 x 63.0 mm
