rhinosys/turingpi2_rack/CAD/RackBladeSolidCraft/exports/step/CL-AR.step

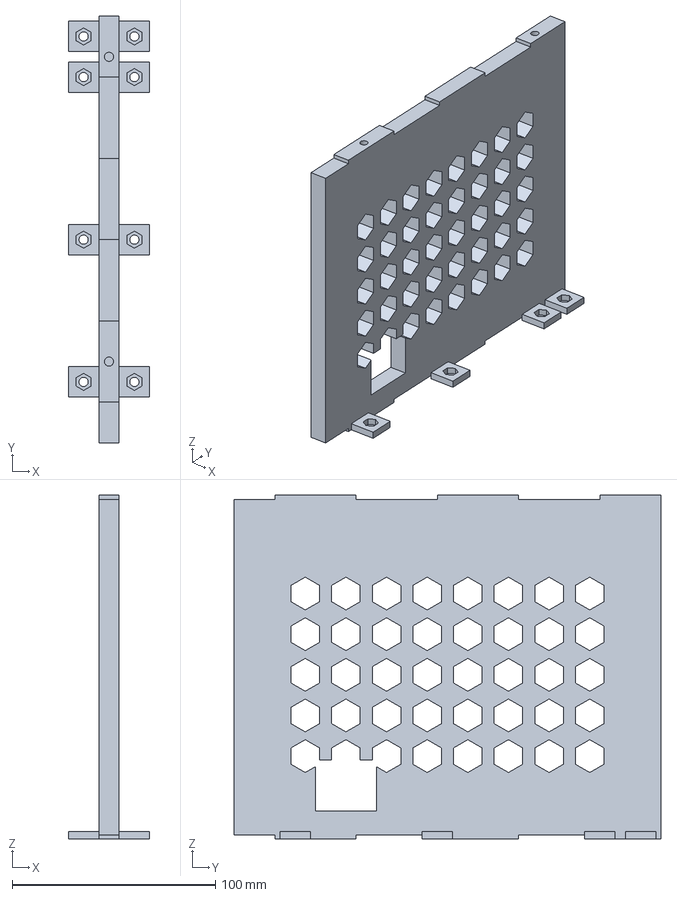
[picture p78: CAD file, 2026-10-26]
CAD/RackBladeSolidCraft/exports/step/CL-AR.step
40.0 x 210.0 x 169.3 mm
