rhinosys/turingpi2_rack/CAD/RackBladeSolidCraft/exports/step/CL-AV.step

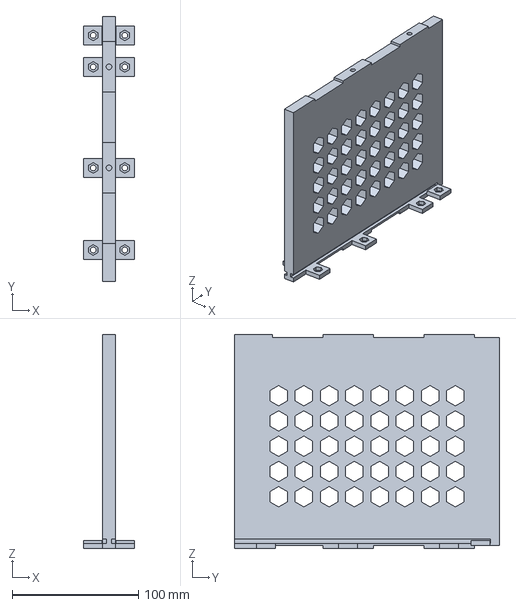
[picture p79: CAD file, 2026-10-26]
CAD/RackBladeSolidCraft/exports/step/CL-AV.step
40.0 x 210.0 x 169.5 mm
