rhinosys/turingpi2_rack/CAD/RackBladeSolidCraft/exports/step/RackTuringPi2_with_ref.step

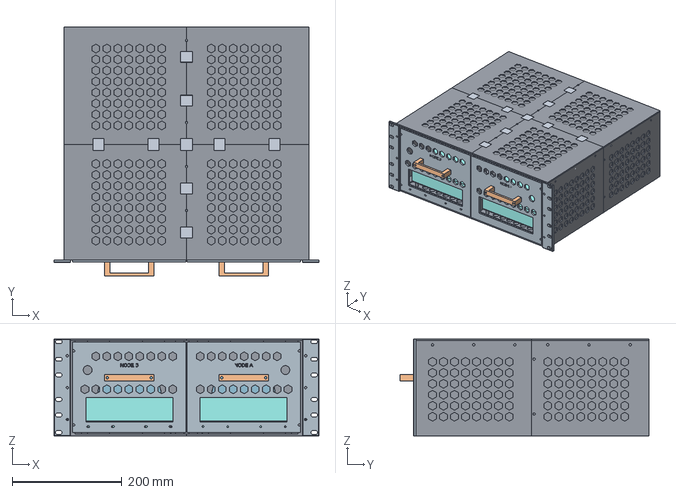
[picture p80: CAD file, 2026-10-26]
CAD/RackBladeSolidCraft/exports/step/RackTuringPi2_with_ref.step
482.6 x 453.0 x 176.5 mm
