rhinosys/turingpi2_rack/CAD/RackBladeSolidCraft/V7/exports/Joint_V7_eclate.step

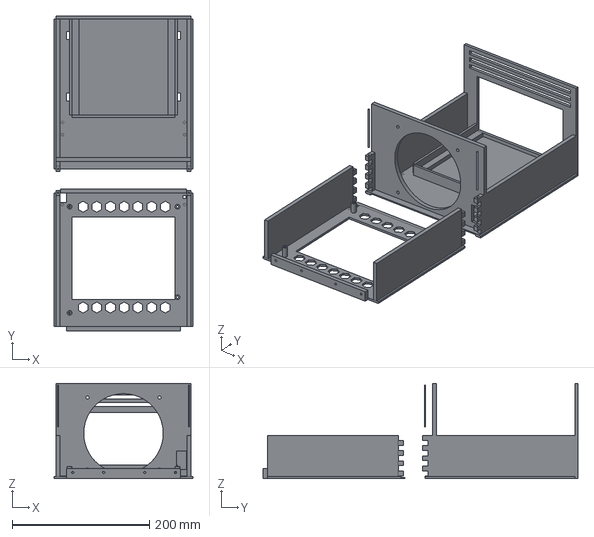
[picture p81: CAD file, 2026-10-26]
CAD/RackBladeSolidCraft/V7/exports/Joint_V7_eclate.step
202.8 x 459.0 x 139.0 mm
