rhinosys/turingpi2_rack/CAD/RackBladeSolidCraft/V7/exports/CASSETTE-G.step

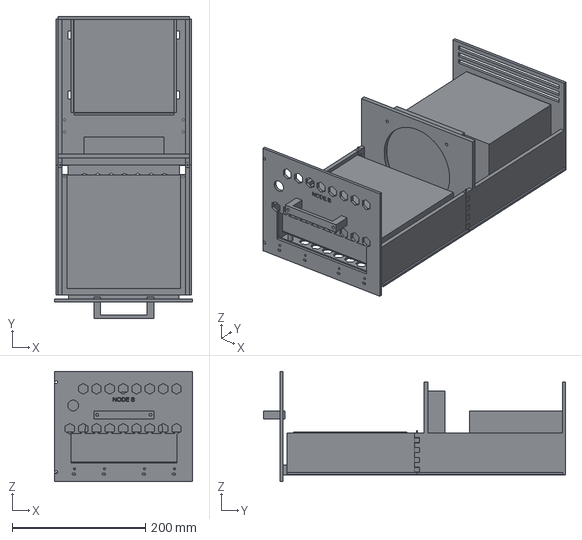
[picture p82: CAD file, 2026-10-26]
CAD/RackBladeSolidCraft/V7/exports/CASSETTE-G.step
207.0 x 453.0 x 165.0 mm
