rhinosys/turingpi2_rack/CAD/RackBladeSolidCraft/exports/step/BIS-X.step

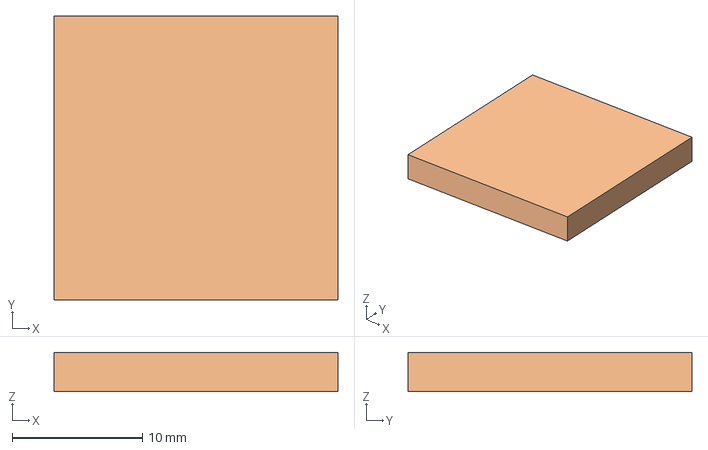
[picture p83: CAD file, 2026-10-26]
CAD/RackBladeSolidCraft/exports/step/BIS-X.step
21.8 x 21.8 x 3.00 mm
