rhinosys/turingpi2_rack/CAD/RackBladeSolidCraft/exports/step/BIS.step

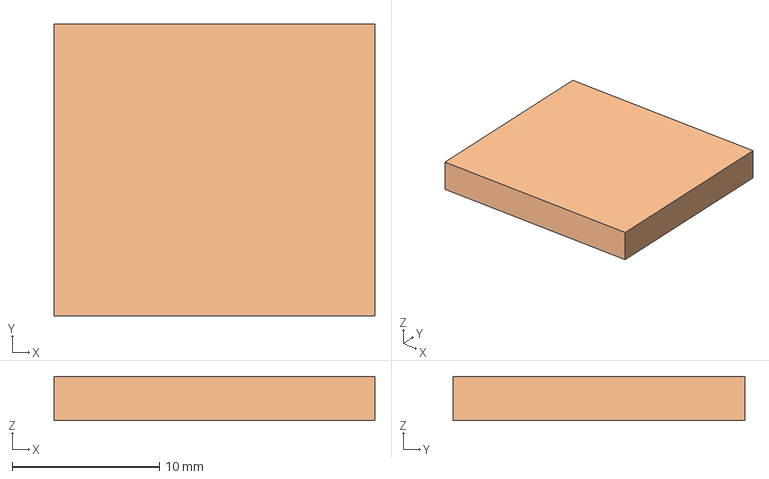
[picture p85: CAD file, 2026-10-26]
CAD/RackBladeSolidCraft/exports/step/BIS.step
21.8 x 19.8 x 3.00 mm
