rhinosys/turingpi2_rack/CAD/RackBladeSolidCraft/V7/exports/TEST-FILAMENT.step

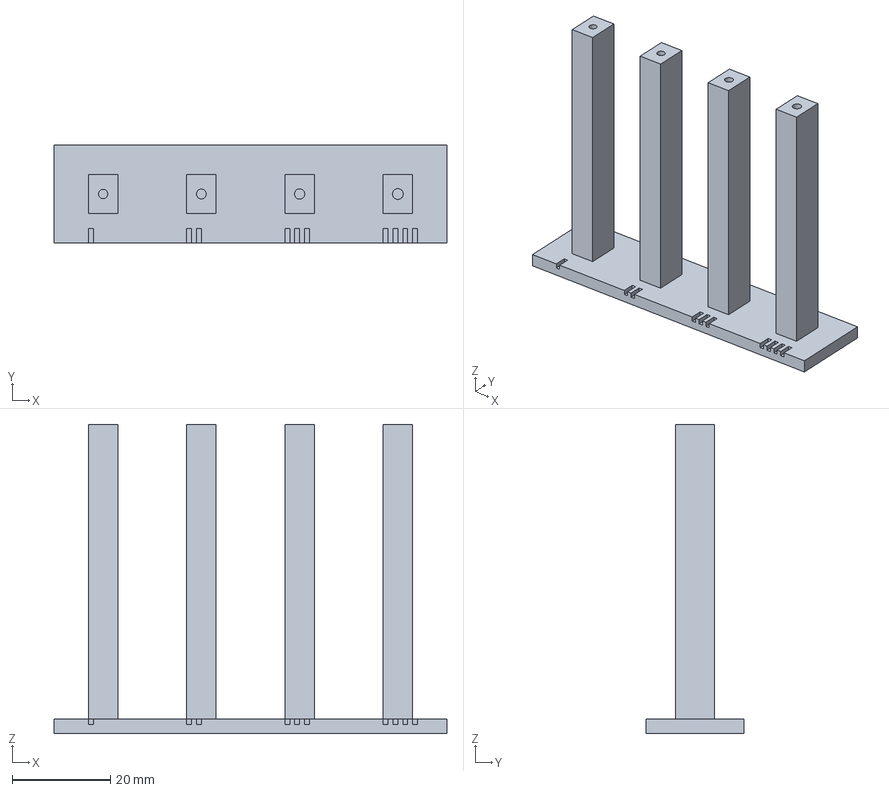
[picture p86: CAD file, 2026-10-26]
CAD/RackBladeSolidCraft/V7/exports/TEST-FILAMENT.step
80.0 x 20.0 x 63.0 mm
