rhinosys/turingpi2_rack/CAD/RackBladeSolidCraft/V7/exports/Cassette_D_vide.step

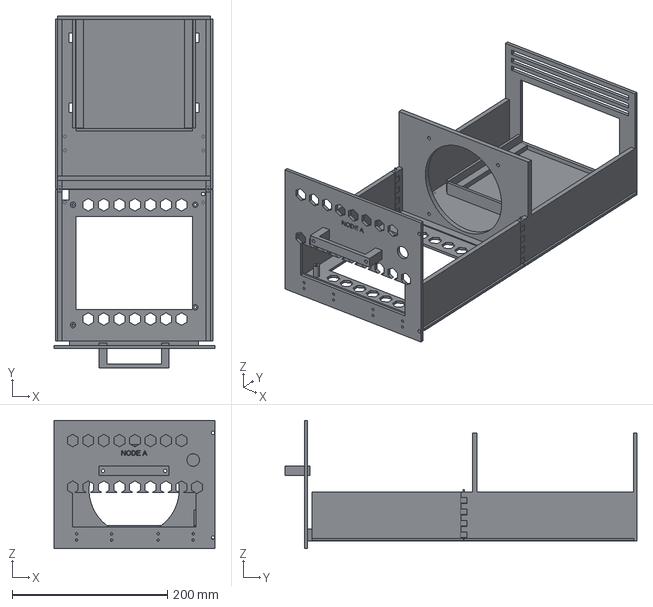
[picture p87: CAD file, 2026-10-26]
CAD/RackBladeSolidCraft/V7/exports/Cassette_D_vide.step
207.0 x 453.0 x 165.0 mm
