rhinosys/turingpi2_rack/(list of files, cad)

Other CAD files:
CAD/RackBladeSolidCraft/Tolerances/Rack_Tolerance_PETG_Noir_X1C.3mf
CAD/RackBladeSolidCraft/V7/exports/Q-AR-G.3mf
CAD/RackBladeSolidCraft/V7/plateaux/02_Q-AV-G-EAR.3mf
CAD/RackBladeSolidCraft/Variants/Q-AV-G-EAR/Q-AV-G-EAR.step
CAD/RackBladeSolidCraft/exports/step/Q-AR-D.step
CAD/RackBladeSolidCraft/Supports_Rails_L/exports/BERCEAU-B.step
CAD/RackBladeSolidCraft/Supports_Rails_L/R2/exports/AV-A.step
CAD/RackBladeSolidCraft/Supports_Rails_L/R3/exports/AV-B.step
CAD/RackBladeSolidCraft/V7/plateaux/03_Q-AR-D.3mf
CAD/RackBladeSolidCraft/Supports_Rails_L/R2/exports/AV-B.step
CAD/RackBladeSolidCraft/V7/exports/BF-D_print.step
CAD/RackBladeSolidCraft/Supports_Rails_L/R3/exports/AR-B.step
CAD/RackBladeSolidCraft/V7/exports/Q-AR-D.3mf
CAD/RackBladeSolidCraft/Supports_Rails_L/R2/exports/AR-B.step
CAD/RackBladeSolidCraft/Supports_Rails_L/R3/exports/AV-A.step
CAD/RackBladeSolidCraft/V7/exports/Q-AR-G_print.step
CAD/RackBladeSolidCraft/V7/plateaux/10_Facade_G_poignee_biscuits.3mf
CAD/RackBladeSolidCraft/V7/exports/Q-AV-G-EAR.3mf
CAD/RackBladeSolidCraft/V7/plateaux/07_BT-G.3mf
CAD/RackBladeSolidCraft/exports/step/HANDLE-D.step
CAD/RackBladeSolidCraft/V7/exports/FOND-AR-D_print.step
CAD/RackBladeSolidCraft/V7/plateaux/04_Q-AR-G.3mf
CAD/RackBladeSolidCraft/exports/step/FW-G.step
CAD/RackBladeSolidCraft/V7/exports/Q-AV-G-EAR_print.step
CAD/RackBladeSolidCraft/V7/exports/BT-D.3mf
CAD/RackBladeSolidCraft/V7/plateaux/06_FOND-AR-D.3mf
CAD/RackBladeSolidCraft/V7/plateaux/05_BT-D.3mf
CAD/RackBladeSolidCraft/exports/step/BT-G.step
CAD/RackBladeSolidCraft/V7/exports/HANDLE-D.3mf
CAD/RackBladeSolidCraft/exports/step/TOP-AV-D.step
CAD/RackBladeSolidCraft/V7/exports/BT-G.3mf
CAD/RackBladeSolidCraft/exports/step/TOP-AR-D.step
CAD/RackBladeSolidCraft/V7/exports/BF-D.3mf
CAD/RackBladeSolidCraft/exports/step/EAR-G.step
CAD/RackBladeSolidCraft/V7/exports/FOND-AR-G.3mf
CAD/RackBladeSolidCraft/V7/exports/BT-G_print.step
CAD/RackBladeSolidCraft/exports/step/Q-AV-D.step
CAD/RackBladeSolidCraft/V7/exports/FOND-AR-D.3mf
CAD/RackBladeSolidCraft/exports/step/BF-D.step
CAD/RackBladeSolidCraft/V7/exports/HANDLE-D_print.step
CAD/RackBladeSolidCraft/V7/exports/BF-G_print.step
CAD/RackBladeSolidCraft/V7/exports/BIS-X_print.step
CAD/RackBladeSolidCraft/exports/step/TOP-AV-G.step
CAD/RackBladeSolidCraft/V7/exports/HANDLE-G_print.step
CAD/RackBladeSolidCraft/V7/exports/BIS-X.3mf
CAD/RackBladeSolidCraft/V7/exports/Q-AV-D.3mf
CAD/RackBladeSolidCraft/V7/exports/FOND-AR-G_print.step
CAD/RackBladeSolidCraft/V7/exports/Q-AV-D_print.step
CAD/RackBladeSolidCraft/V7/exports/BIS_print.step
CAD/RackBladeSolidCraft/V7/exports/HANDLE-G.3mf
CAD/RackBladeSolidCraft/V7/exports/CASSETTE-D.step
CAD/RackBladeSolidCraft/V7/exports/BF-G.3mf
CAD/RackBladeSolidCraft/V7/exports/BIS.3mf
CAD/RackBladeSolidCraft/Supports_Rails_L/R2/exports/AR-A.3mf
CAD/RackBladeSolidCraft/Supports_Rails_L/R2/exports/AR-B.3mf
CAD/RackBladeSolidCraft/Supports_Rails_L/R2/exports/AV-A.3mf
CAD/RackBladeSolidCraft/Supports_Rails_L/R2/exports/AV-B.3mf
CAD/RackBladeSolidCraft/Supports_Rails_L/R3/exports/AR-A.3mf
CAD/RackBladeSolidCraft/Supports_Rails_L/R3/exports/AR-B.3mf
CAD/RackBladeSolidCraft/Supports_Rails_L/R3/exports/AV-A.3mf
CAD/RackBladeSolidCraft/Supports_Rails_L/R3/exports/AV-B.3mf
CAD/RackBladeSolidCraft/Supports_Rails_L/exports/BERCEAU-A.3mf
CAD/RackBladeSolidCraft/Supports_Rails_L/exports/BERCEAU-B.3mf
CAD/RackBladeSolidCraft/Tolerances/Rack_Tolerance_PETG_R1.3mf
CAD/RackBladeSolidCraft/Tolerances/Rack_Tolerance_PETG_R1.stl
CAD/RackBladeSolidCraft/V5/exports/Assemblage_V5.step
CAD/RackBladeSolidCraft/V5/exports/BF-D.3mf
CAD/RackBladeSolidCraft/V5/exports/BF-G.3mf
CAD/RackBladeSolidCraft/V5/exports/BIS-X.3mf
CAD/RackBladeSolidCraft/V5/exports/BIS.3mf
CAD/RackBladeSolidCraft/V5/exports/BT-D.3mf
CAD/RackBladeSolidCraft/V5/exports/BT-G.3mf
CAD/RackBladeSolidCraft/V5/exports/CASSETTE-D.step
CAD/RackBladeSolidCraft/V5/exports/CASSETTE-G.step
CAD/RackBladeSolidCraft/V5/exports/CL-AR.3mf
CAD/RackBladeSolidCraft/V5/exports/CL-AV.3mf
CAD/RackBladeSolidCraft/V5/exports/Cassette_D_vue.step
CAD/RackBladeSolidCraft/V5/exports/EAR-D.3mf
CAD/RackBladeSolidCraft/V5/exports/ECLISSE-D-1.3mf
CAD/RackBladeSolidCraft/V5/exports/ECLISSE-D-2.3mf
CAD/RackBladeSolidCraft/V5/exports/ECLISSE-G-1.3mf
CAD/RackBladeSolidCraft/V5/exports/ECLISSE-G-2.3mf
CAD/RackBladeSolidCraft/V5/exports/FOND-AR-D.3mf
CAD/RackBladeSolidCraft/V5/exports/FOND-AR-G.3mf
CAD/RackBladeSolidCraft/V5/exports/HANDLE-D.3mf
CAD/RackBladeSolidCraft/V5/exports/HANDLE-G.3mf
CAD/RackBladeSolidCraft/V5/exports/Q-AR-D.3mf
CAD/RackBladeSolidCraft/V5/exports/Q-AR-D_print.step
CAD/RackBladeSolidCraft/V5/exports/Q-AR-G.3mf
CAD/RackBladeSolidCraft/V5/exports/Q-AR-G_print.step
CAD/RackBladeSolidCraft/V5/exports/Q-AV-D.3mf
CAD/RackBladeSolidCraft/V5/exports/Q-AV-D_print.step
CAD/RackBladeSolidCraft/V5/exports/Q-AV-G-EAR.3mf
CAD/RackBladeSolidCraft/V5/exports/Q-AV-G-EAR_print.step
CAD/RackBladeSolidCraft/V5/exports/TOP-AR-D.3mf
CAD/RackBladeSolidCraft/V5/exports/TOP-AR-G.3mf
CAD/RackBladeSolidCraft/V5/exports/TOP-AV-D.3mf
CAD/RackBladeSolidCraft/V5/exports/TOP-AV-G.3mf
CAD/RackBladeSolidCraft/V5/exports/Vue_extraction_V5.step
CAD/RackBladeSolidCraft/V6/exports/Assemblage_V6.step
CAD/RackBladeSolidCraft/V6/exports/BF-D.3mf
CAD/RackBladeSolidCraft/V6/exports/BF-G.3mf
CAD/RackBladeSolidCraft/V6/exports/BIS-X.3mf
CAD/RackBladeSolidCraft/V6/exports/BIS.3mf
CAD/RackBladeSolidCraft/V6/exports/BT-D.3mf
CAD/RackBladeSolidCraft/V6/exports/BT-G.3mf
CAD/RackBladeSolidCraft/V6/exports/CASSETTE-D.step
CAD/RackBladeSolidCraft/V6/exports/CASSETTE-G.step
CAD/RackBladeSolidCraft/V6/exports/ECLISSE-D-1.3mf
CAD/RackBladeSolidCraft/V6/exports/ECLISSE-D-2.3mf
CAD/RackBladeSolidCraft/V6/exports/ECLISSE-G-1.3mf
CAD/RackBladeSolidCraft/V6/exports/ECLISSE-G-2.3mf
CAD/RackBladeSolidCraft/V6/exports/Enclosure_V6.step
CAD/RackBladeSolidCraft/V6/exports/FOND-AR-D.3mf
CAD/RackBladeSolidCraft/V6/exports/FOND-AR-G.3mf
CAD/RackBladeSolidCraft/V6/exports/HANDLE-D.3mf
CAD/RackBladeSolidCraft/V6/exports/HANDLE-G.3mf
CAD/RackBladeSolidCraft/V6/exports/Q-AR-D.3mf
CAD/RackBladeSolidCraft/V6/exports/Q-AR-D_print.step
CAD/RackBladeSolidCraft/V6/exports/Q-AR-G.3mf
CAD/RackBladeSolidCraft/V6/exports/Q-AR-G_print.step
CAD/RackBladeSolidCraft/V6/exports/Q-AV-D.3mf
CAD/RackBladeSolidCraft/V6/exports/Q-AV-D_print.step
CAD/RackBladeSolidCraft/V6/exports/Q-AV-G-EAR.3mf
CAD/RackBladeSolidCraft/V6/exports/Q-AV-G-EAR_print.step
CAD/RackBladeSolidCraft/V7/exports/TEST-FILAMENT.3mf
CAD/RackBladeSolidCraft/V7/exports/TEST-JONCTION.3mf
CAD/RackBladeSolidCraft/exports/3mf/BF-D.3mf
CAD/RackBladeSolidCraft/exports/3mf/BF-G.3mf
CAD/RackBladeSolidCraft/exports/3mf/BIS-X.3mf
CAD/RackBladeSolidCraft/exports/3mf/BIS.3mf
CAD/RackBladeSolidCraft/exports/3mf/BT-D.3mf
CAD/RackBladeSolidCraft/exports/3mf/BT-G.3mf
CAD/RackBladeSolidCraft/exports/3mf/CL-AR.3mf
CAD/RackBladeSolidCraft/exports/3mf/CL-AV.3mf
CAD/RackBladeSolidCraft/exports/3mf/EAR-D.3mf
CAD/RackBladeSolidCraft/exports/3mf/EAR-G.3mf
CAD/RackBladeSolidCraft/exports/3mf/FW-D.3mf
CAD/RackBladeSolidCraft/exports/3mf/FW-G.3mf
CAD/RackBladeSolidCraft/exports/3mf/HANDLE-D.3mf
CAD/RackBladeSolidCraft/exports/3mf/HANDLE-G.3mf
CAD/RackBladeSolidCraft/exports/3mf/Q-AR-D.3mf
CAD/RackBladeSolidCraft/exports/3mf/Q-AR-G.3mf
CAD/RackBladeSolidCraft/exports/3mf/Q-AV-D.3mf
CAD/RackBladeSolidCraft/exports/3mf/Q-AV-G.3mf
CAD/RackBladeSolidCraft/exports/3mf/TOP-AR-D.3mf
CAD/RackBladeSolidCraft/exports/3mf/TOP-AR-G.3mf
CAD/RackBladeSolidCraft/exports/3mf/TOP-AV-D.3mf
CAD/RackBladeSolidCraft/exports/3mf/TOP-AV-G.3mf
