rhinosys/turingpi2_rack/CAD/RackBladeSolidCraft/notice-visuelle/print-BF-D.png

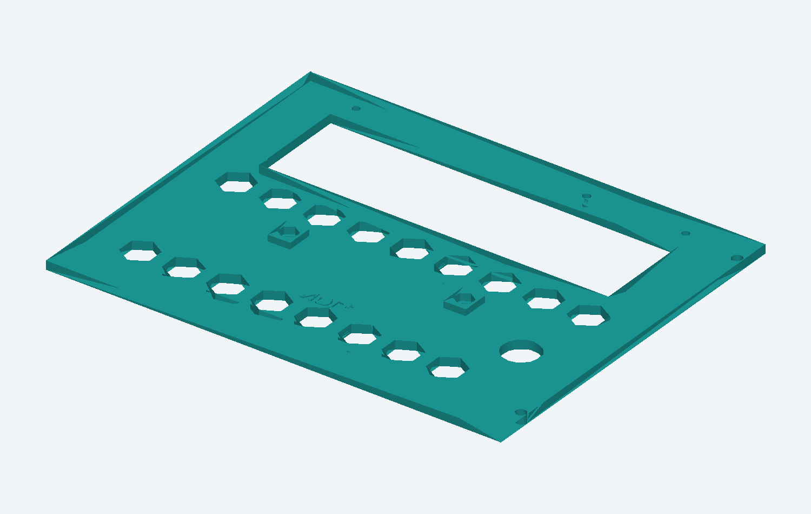
CAD/RackBladeSolidCraft/notice-visuelle/print-BF-D.png
