rhinosys/turingpi2_rack/CAD/RackBladeSolidCraft/notice-visuelle/print-BIS-X.png

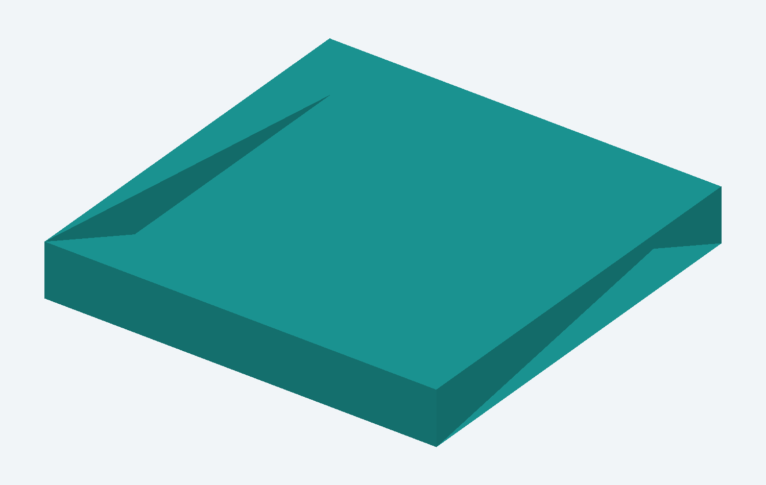
CAD/RackBladeSolidCraft/notice-visuelle/print-BIS-X.png
