rhinosys/turingpi2_rack/CAD/RackBladeSolidCraft/notice-visuelle/print-BIS.png

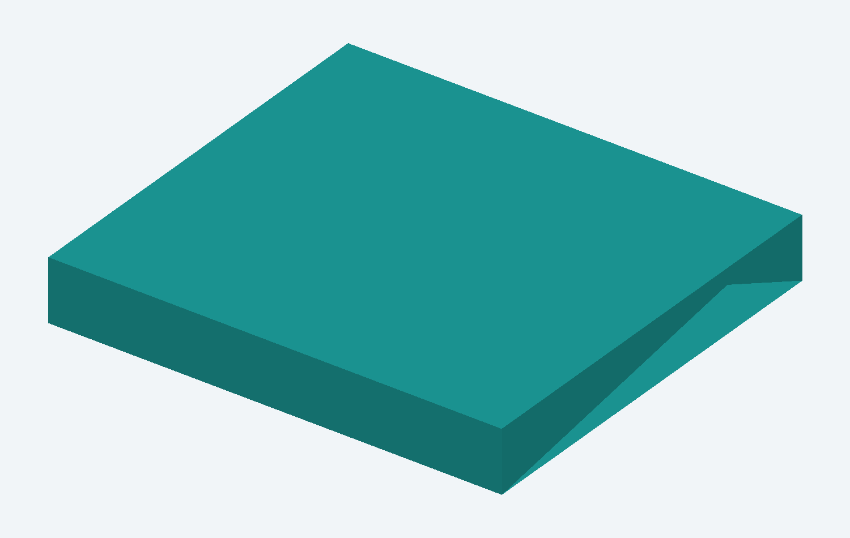
CAD/RackBladeSolidCraft/notice-visuelle/print-BIS.png
