rhinosys/turingpi2_rack/CAD/RackBladeSolidCraft/notice-visuelle/print-BT-D.png

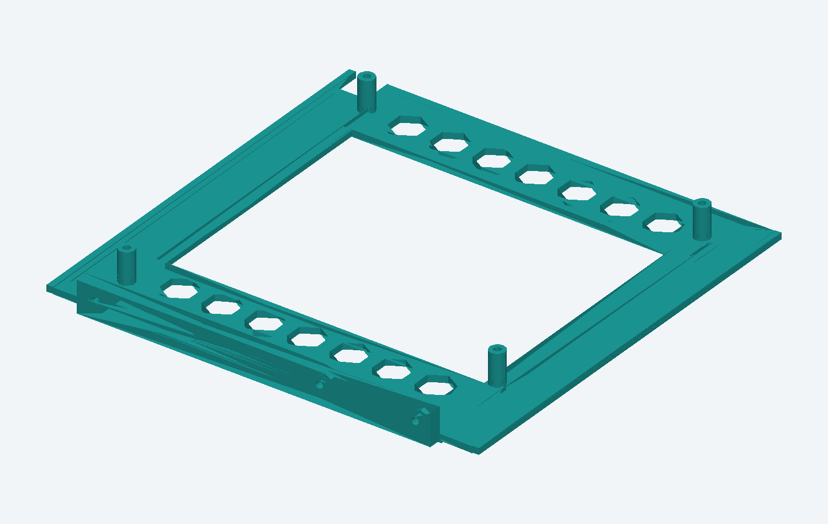
CAD/RackBladeSolidCraft/notice-visuelle/print-BT-D.png
