rhinosys/turingpi2_rack/CAD/RackBladeSolidCraft/notice-visuelle/print-CL-AR.png

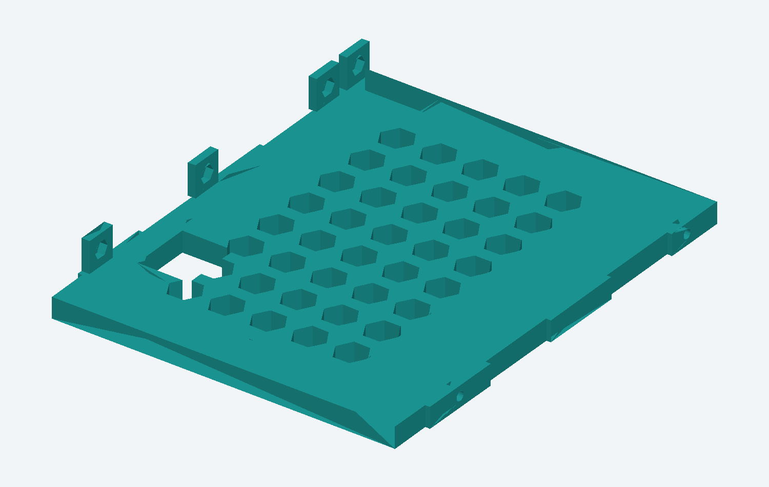
CAD/RackBladeSolidCraft/notice-visuelle/print-CL-AR.png
