rhinosys/turingpi2_rack/CAD/RackBladeSolidCraft/notice-visuelle/print-CL-AV.png

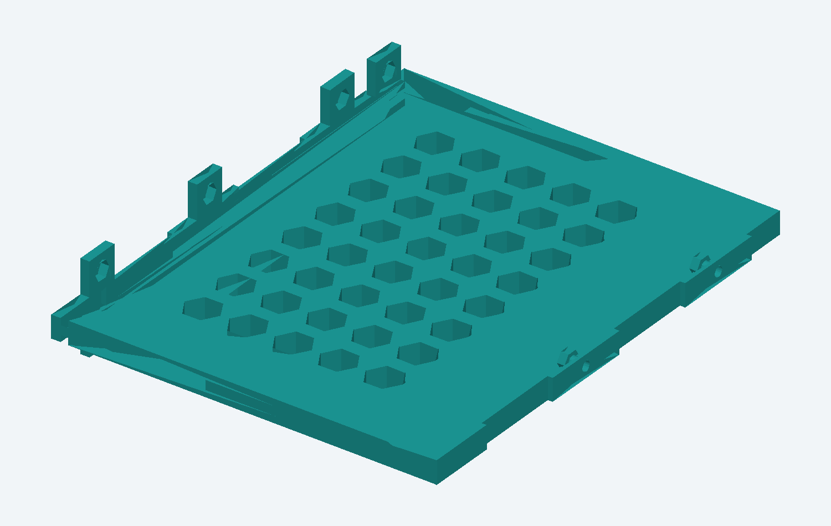
CAD/RackBladeSolidCraft/notice-visuelle/print-CL-AV.png
