rhinosys/turingpi2_rack/CAD/RackBladeSolidCraft/notice-visuelle/print-EAR-D.png

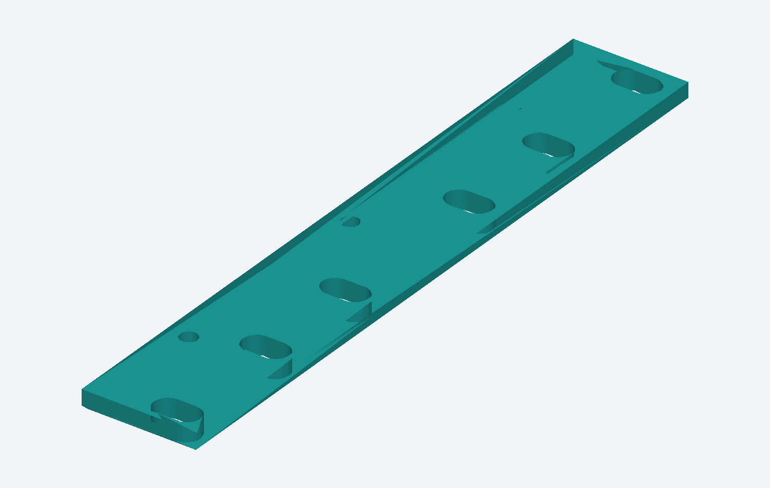
CAD/RackBladeSolidCraft/notice-visuelle/print-EAR-D.png
