rhinosys/turingpi2_rack/CAD/RackBladeSolidCraft/notice-visuelle/print-FW-D.png

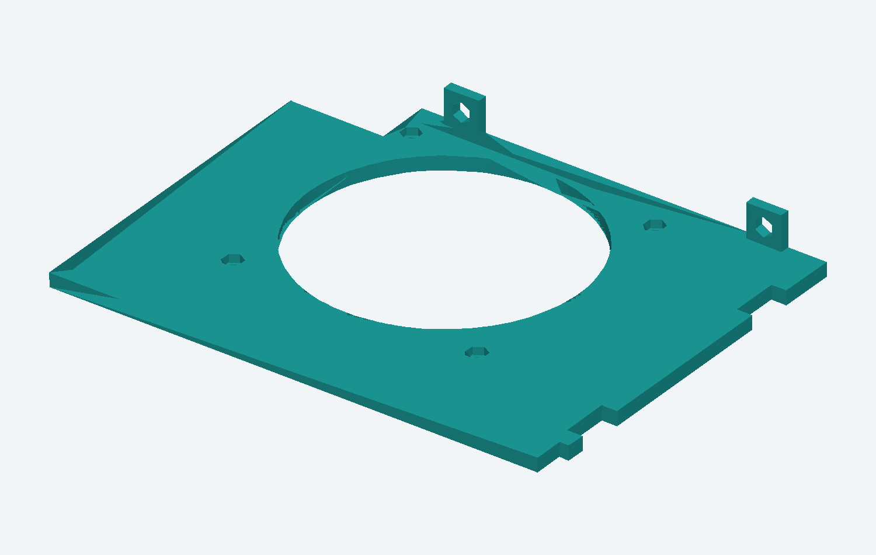
CAD/RackBladeSolidCraft/notice-visuelle/print-FW-D.png
