rhinosys/turingpi2_rack/CAD/RackBladeSolidCraft/notice-visuelle/print-FW-G.png

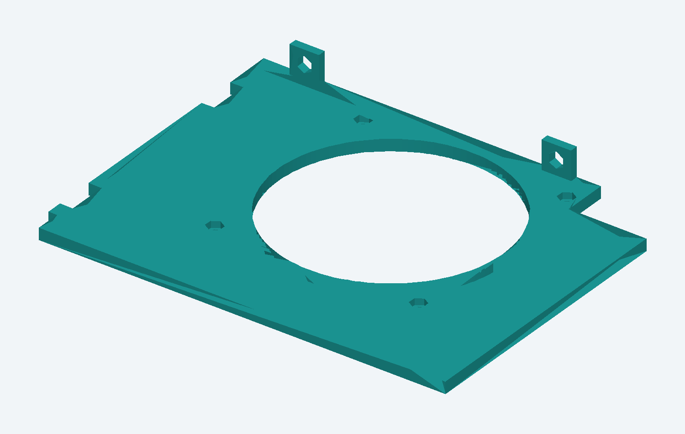
CAD/RackBladeSolidCraft/notice-visuelle/print-FW-G.png
