rhinosys/turingpi2_rack/CAD/RackBladeSolidCraft/notice-visuelle/print-HANDLE-D.png

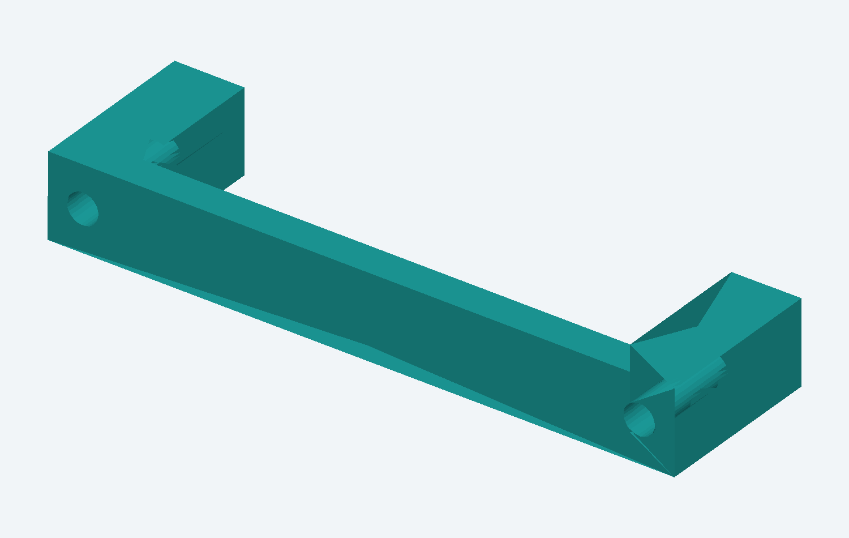
CAD/RackBladeSolidCraft/notice-visuelle/print-HANDLE-D.png
