rhinosys/turingpi2_rack/CAD/RackBladeSolidCraft/notice-visuelle/print-Q-AR-D.png

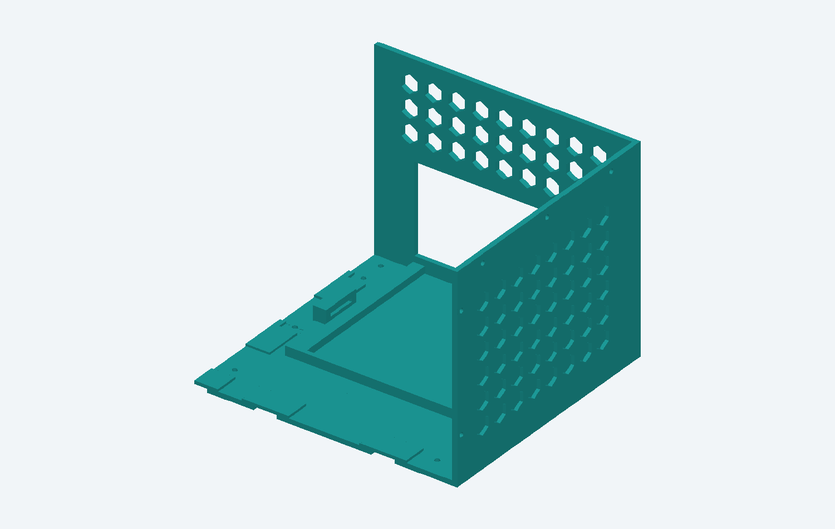
CAD/RackBladeSolidCraft/notice-visuelle/print-Q-AR-D.png
