rhinosys/turingpi2_rack/CAD/RackBladeSolidCraft/notice-visuelle/print-Q-AR-G.png

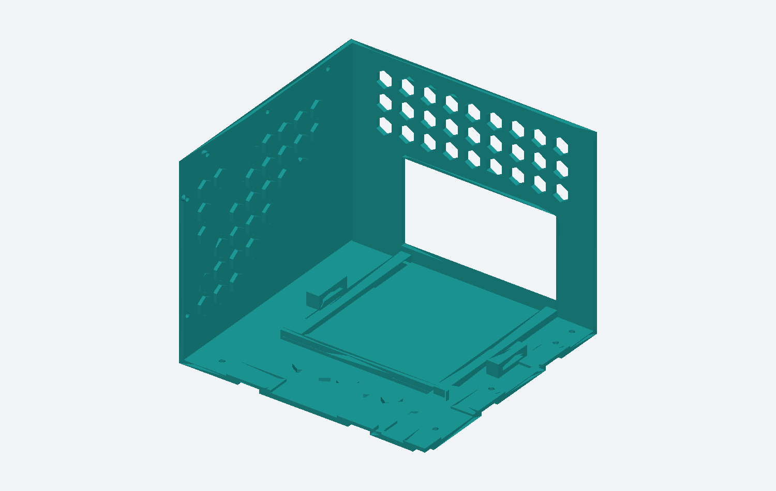
CAD/RackBladeSolidCraft/notice-visuelle/print-Q-AR-G.png
