rhinosys/turingpi2_rack/CAD/RackBladeSolidCraft/notice-visuelle/print-Q-AV-D.png

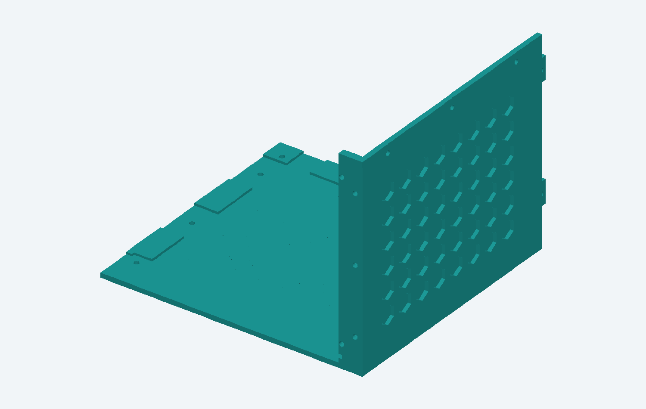
CAD/RackBladeSolidCraft/notice-visuelle/print-Q-AV-D.png
