rhinosys/turingpi2_rack/CAD/RackBladeSolidCraft/notice-visuelle/print-Q-AV-G.png

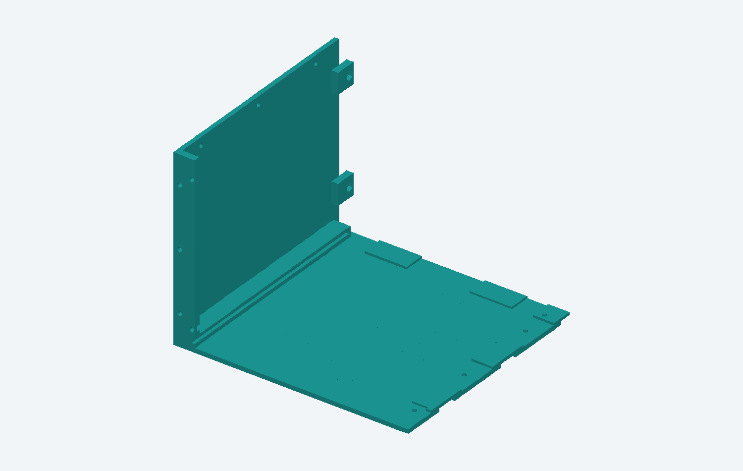
CAD/RackBladeSolidCraft/notice-visuelle/print-Q-AV-G.png
