rhinosys/turingpi2_rack/CAD/RackBladeSolidCraft/notice-visuelle/print-TOP-AR-D.png

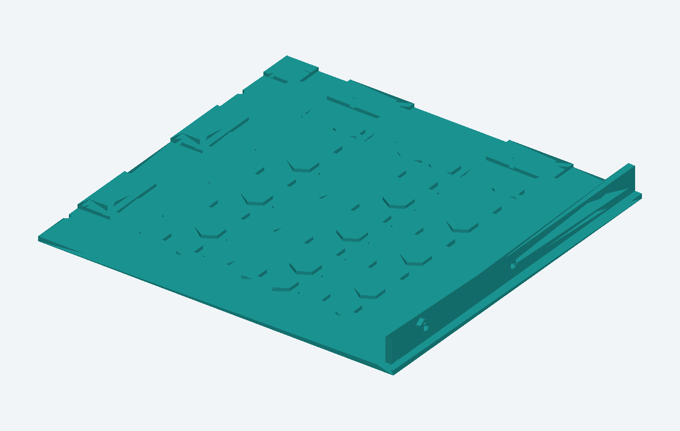
CAD/RackBladeSolidCraft/notice-visuelle/print-TOP-AR-D.png
