rhinosys/turingpi2_rack/CAD/RackBladeSolidCraft/notice-visuelle/print-TOP-AV-G.png

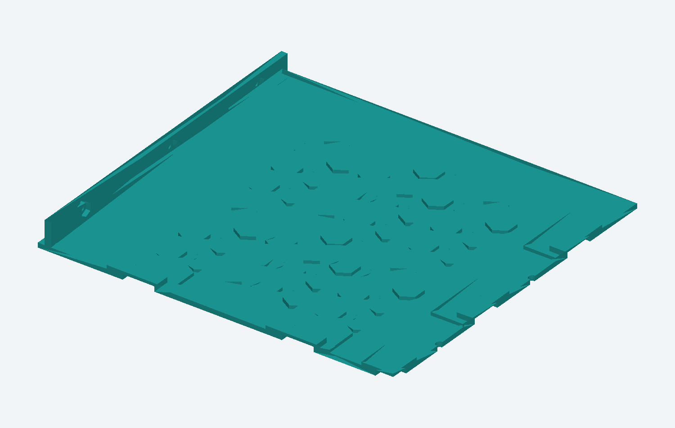
CAD/RackBladeSolidCraft/notice-visuelle/print-TOP-AV-G.png
