rhinosys/turingpi2_rack/CAD/RackBladeSolidCraft/previews/assembly-back.png

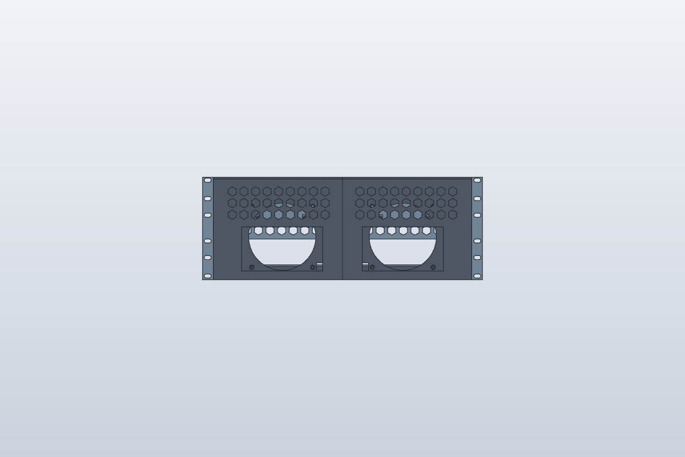
CAD/RackBladeSolidCraft/previews/assembly-back.png
