rhinosys/turingpi2_rack/CAD/RackBladeSolidCraft/previews/assembly-top.png

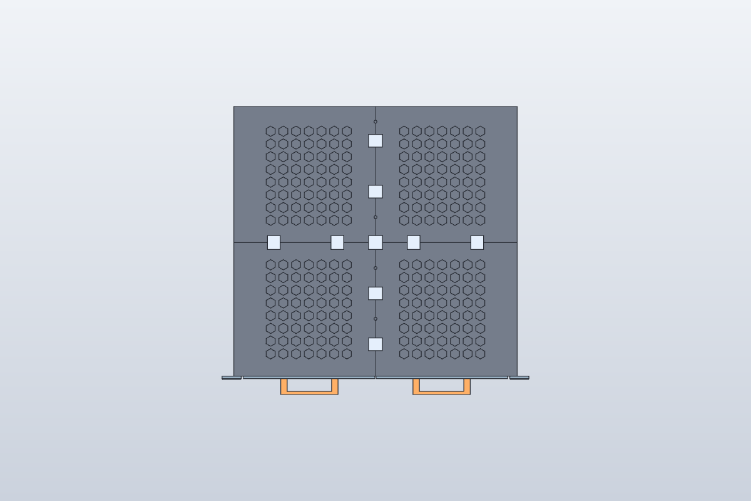
CAD/RackBladeSolidCraft/previews/assembly-top.png
