rhinosys/turingpi2_rack/CAD/RackBladeSolidCraft/verification/guidage-central/README.md

# Guidage des deux nodes — contrôle du 25 octobre 2026

## Architecture
La cloison CL-AV est présente dans le modèle complet, y compris la variante Q-AV-G-EAR. Le rendu précédent de la pièce fusionnée seule ne la montrait pas. Chaque tiroir doit être engagé dans deux rainures : celle du quadrant extérieur et celle de la cloison centrale. CL-AR prolonge la séparation dans la zone arrière ; CL-AV assure le guidage intérieur des tiroirs avant.

## Composants
CL-AV comporte deux rainures, une sur chaque face. La construction nominale définit une cloison de 10 mm d'épaisseur, des rainures de 3 mm de profondeur et 3,4 mm de hauteur sur 203 mm de longueur. Les languettes des tiroirs font 3 mm de hauteur, soit un jeu vertical nominal total de 0,4 mm (0,2 mm dessus et dessous). Ces cotes restent soumises à la validation des éprouvettes PETG.

## Modèle et visuel
La mesure MCP de CL-AV confirme sa présence : enveloppe avec pieds X = −20 à +20 mm, Y = 0 à 210 mm, Z = 4 à 173,5 mm ; volume 284 826,840 mm³, une coque. La vue est produite à partir des maillages R3 exportés. Les tiroirs sont avancés de 65 et 25 mm pour rendre leur indépendance lisible ; les parois extérieures sont masquées. Les couleurs sont pédagogiques, impression noire.

Cloison centrale et tiroirs

## Comment tester
Fixer la cloison et les quadrants avant d'essayer les tiroirs. Engager simultanément la languette extérieure et la languette intérieure, puis vérifier la course à vide sans point dur. Répéter après montage des équipements. La vérification de collision en position fermée ne valide pas la course complète ni les tolérances réelles d'impression.

## Prochaines améliorations
Les entrées de rainure et leur chanfrein restent à finaliser après l'essai de tolérances, comme indiqué dans le rapport R1. Aucune nouvelle cloison n'est ajoutée : le guide central existe déjà. La géométrie et les exports d'impression sont inchangés par ce contrôle.
