rhinosys/turingpi2_rack/CAD/RackBladeSolidCraft/V7/plateaux/11_OPTION_Test_filament_et_jonction.png

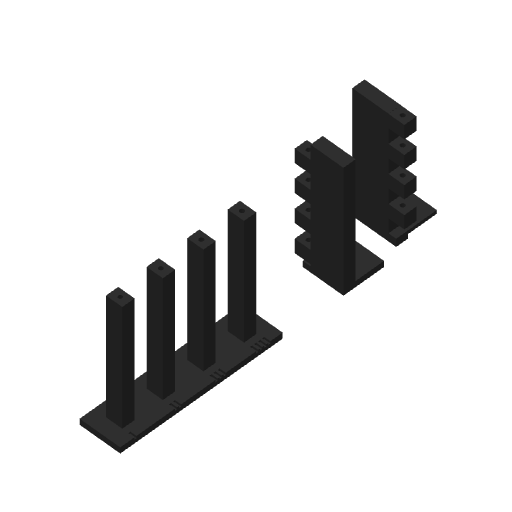
CAD/RackBladeSolidCraft/V7/plateaux/11_OPTION_Test_filament_et_jonction.png
