rhinosys/turingpi2_rack/(commit log)

2026-10-26 feat: publish SolidCraft rack sources and bilingual MkDocs guide
    [01_Q-AV-D.3mf, 02_Q-AV-G-EAR.3mf, 03_Q-AR-D.3mf, 04_Q-AR-G.3mf, 05_BT-D.3mf, 06_FOND-AR-D.3mf, 07_BT-G.3mf, 08_FOND-AR-G.3mf]
2026-10-26 fix: preserve CAD snapshot checksums across Git checkouts
